judapies/Cabina-Flujo-Vertical/2020/CFLV 90 Avantika Vidrio Electrico #004588284 OP202004/Interfaz Nextion 3.5 Extractora/Imagenes/CabinaB2.png

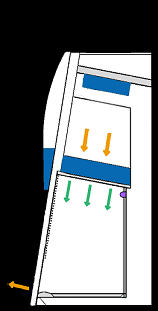
2020/CFLV 90 Avantika Vidrio Electrico #004588284 OP202004/Interfaz Nextion 3.5 Extractora/Imagenes/CabinaB2.png
