judapies/Cabina-Flujo-Vertical/2020/CFLV 90 Avantika Vidrio Electrico #004588284 OP202004/Interfaz Nextion/Imagenes/SOFTWARE_AUTOCLAVE _HORIZONTAL_68L_02-40.png

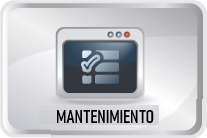
2020/CFLV 90 Avantika Vidrio Electrico #004588284 OP202004/Interfaz Nextion/Imagenes/SOFTWARE_AUTOCLAVE _HORIZONTAL_68L_02-40.png
