judapies/Cabina-Flujo-Vertical/Materiales/Listado de Componentes Cabina de Flujo Laminar  Vertical.xlsx

Sheet: Parte Electronica 110V
 | Cabina Flujo Vertical 110V
 | Descripción | Referencia | Cantidad | Precio | Precio Total | Sitio de Compra | Dirección
 | OptoTriac | MOC3031 | 6 | $2088 | $12528 | Sigma Electronica Ltda | Av. Cra 24 No 61D-65
 | Triac | BT137 | 2 | $1000 | $2000 | Electronica Digitel Ltda | Cra 9 # 19-30 LOC:216/217
 |  | BTA-16 | 4 | $2030 | $8120 | Sigma Electronica Ltda | Av. Cra 24 No 61D-65
 | Borneras | 2 Pines Verdes | 7 | $350 | $2450 | Electronica Digitel Ltda | Cra 9 # 19-30 LOC:216/217
 |  | 3 Pines Verde | 1 | $400 | $400 | Electronica Digitel Ltda | Cra 9 # 19-30 LOC:216/218
 | Conectores GP (con uñas) | 5 Pines | 1 | $400 | $400 | Electronica Digitel Ltda | Cra 9 # 19-30 LOC:216/219
 |  | 16 Pines | 2 | $800 | $1600 | Electronica Digitel Ltda | Cra 9 # 19-30 LOC:216/220
 | Fusible Corto | 500 mA maximo | 1 | $100 | $100 | Electronica Digitel Ltda | Cra 9 # 19-30 LOC:216/221
 | Portafusible Aereo | Para fusible corto | 1 | $600 | $600 | Electronica Digitel Ltda | Cra 9 # 19-30 LOC:216/222
 | Disipador | Mediano para 7805 | 1 | $2000 | $2000 | Electronica Digitel Ltda | Cra 9 # 19-30 LOC:216/223
 | Puente Rectificador | Redondo 1A | 1 | $400 | $400 | Electronica Digitel Ltda | Cra 9 # 19-30 LOC:216/224
 | Regulador de Voltaje | LM7805 | 1 | $550 | $550 | Electronica Digitel Ltda | Cra 9 # 19-30 LOC:216/225
 | Reostato | 10K | 1 | $300 | $300 | Electronica Digitel Ltda | Cra 9 # 19-30 LOC:216/226
 | Cristal de Cuarzo | 4MHz | 1 | $450 | $450 | Electronica Digitel Ltda | Cra 9 # 19-30 LOC:216/227
 | Resistencias 1/4W | 10K | 6 | $10 | $60 | Electronica Digitel Ltda | Cra 9 # 19-30 LOC:216/228
 |  | 1K | 6 | $10 | $60 | Electronica Digitel Ltda | Cra 9 # 19-30 LOC:216/229
 |  | 330R | 6 | $10 | $60 | Electronica Digitel Ltda | Cra 9 # 19-30 LOC:216/230
 | Condensador | 470uF/25V | 1 | $250 | $250 | Electronica Digitel Ltda | Cra 9 # 19-30 LOC:216/231
 |  | 10uF/16V | 3 | $150 | $450 | Electronica Digitel Ltda | Cra 9 # 19-30 LOC:216/232
 |  | 100nF (104) | 2 | $100 | $200 | Electronica Digitel Ltda | Cra 9 # 19-30 LOC:216/233
 |  | 22pF | 2 | $100 | $200 | Electronica Digitel Ltda | Cra 9 # 19-30 LOC:216/234
 | Display | 4X20 | 1 | $25000 | $25000 | Electronica Digitel Ltda | Cra 9 # 19-30 LOC:216/235
 | Transformador | 110V a 0-6-9V 450mA | 1 | $6500 | $6500 | Electronica Digitel Ltda | Cra 9 # 19-30 LOC:216/236
 | Varistor | 20D241K | 2 | $2000 | $4000 | Electronica Digitel Ltda | Cra 9 # 19-30 LOC:216/237
 | Microcontrolador | PIC 18F4550 | 1 | $15000 | $15000 | Electronica Digitel Ltda | Cra 9 # 19-30 LOC:216/238
 | Regleta Profesional | 40 pines | 3 | $1200 | $3600 | Electronica Digitel Ltda | Cra 9 # 19-30 LOC:216/217
 | Poste plastico | Para sujecion de tarjeta | 4 | $150 | $600 | Electronica Digitel Ltda | Cra 9 # 19-30 LOC:216/217
 | Tarjetas Electronicas | Control | 1 | $17000 | $17000 | Yahiko Electronica Ltda | Calle 20 # 8-89
 | Botones | Tipo huevo blanco | 4 | $1800 | $7200 | ATM Store SAS | Cra 9 # 19-30 LOC: 117
 |  |  |  |  | $112078 | TOTAL
Ingenieros | Faiver H. Trujillo G | Juan David Piñeros E | 2014- Abr-15

Sheet: Parte Electrica 110V
Cabina Flujo Vertical 110V
Descripción | Referencia | Cantidad | Precio Unitario | Precio Total
Breaker CHINT 1 polo | 2A | 1 | $10000 | $10000
 | 10A | 1 | $10000 | $10000
Interruptor de balancin redondo | 20mm | 1 | $3000 | $3000
Toma doble blanca | Leviton | 1 | $2800 | $2800
Tapa de seguridad para toma doble | Plastica gris | 1 | $8000 | $8000
Regleta de polietileno | 30A | 1 | $4500 | $4500
Prensacable | PG11 | 4 | $1000 | $4000
Cable Encauchetado Conalcables | 3X12 | 4 | $4500 | $18000
Clavija | 110V 15A Leviton | 1 | $6500 | $6500
 |  |  |  | $66800

Sheet: 220V
 | Cabina Flujo Vertical 220V
 | Descripción | Referencia | Cantidad
 | OptoTriac | MOC3021 | 6
 | Triac | BT137 | 2
 |  | BTA-16 | 4
 | Borneras | 2 Pines Verdes | 7
 |  | 3 Pines Verde | 1
 | Conectores GP (con uñas) | 5 Pines | 1
 |  | 16 Pines | 2
 | Puente Rectificador | Redondo 1A | 1
 | Regulador de Voltaje | LM7805 | 1
 | Reostato | 10K | 1
 | Cristal de Cuarzo | 4MHz | 1
 | Resistencias 1/4W | 10K | 6
 |  | 1K | 6
 |  | 330R | 6
 | Condensador | 470uF/25V | 1
 |  | 10uF/16V | 3
 |  | 100nF (104) | 2
 |  | 22pF | 2
 | Display | 4X20 | 1
 | Microcontrolador | PIC 18F4550 | 1
 | Terminales | Según muestra | 8
 | Breaker CHINT 2 polos | 2A | 1
 | Breaker CHINT 1 polo | 10A | 1
 | Interruptor de balancin redondo | 20mm | 1
 | Toma doble blanca | Leviton | 1
 | Tapa de seguridad para toma doble | Plastica gris | 1
 | Regleta de polietileno | 15A | 1
 | Prensacable | PG11 | 4
 | Cable Encauchetado Conalcables | 4X12 | 3m
Ingenieros | Faiver H. Trujillo G | Juan David Piñeros E | 2014- Abr-15
