judapies/Cabina-Flujo-Vertical/2016/CFLV 120 UPTC/Schematic/Cabina_PCR.DXF

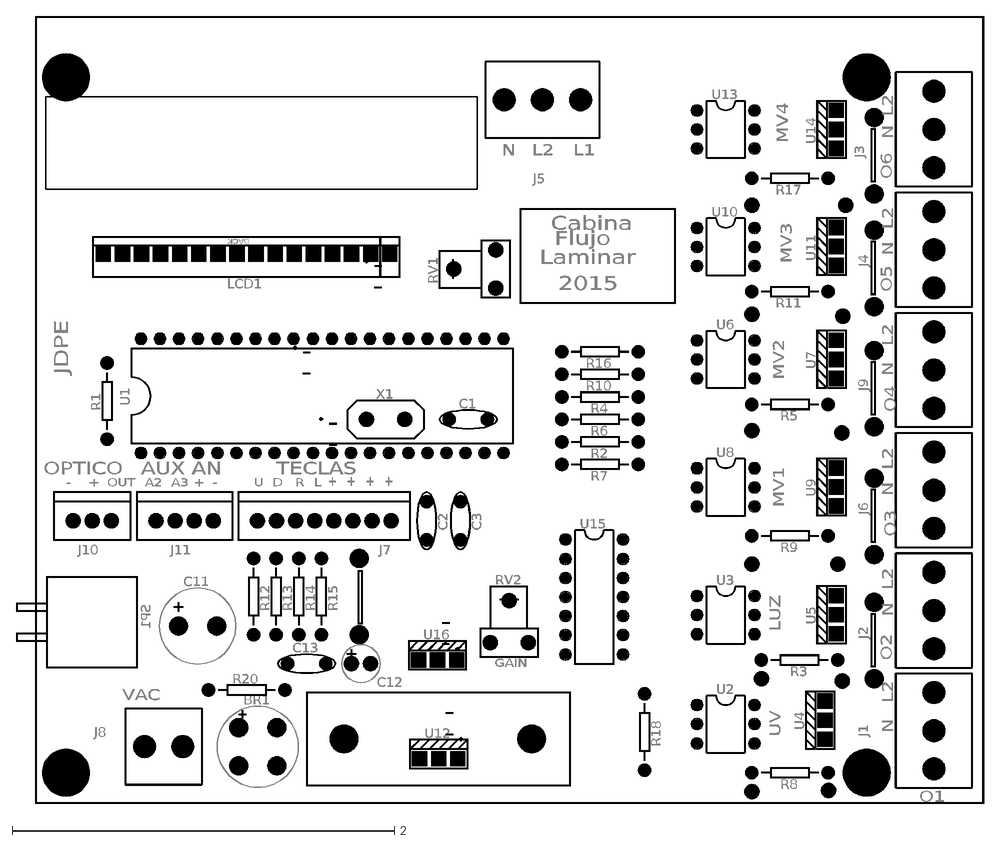
[picture p21: CAD file, 2021-07-15]
2016/CFLV 120 UPTC/Schematic/Cabina_PCR.DXF
BR1
U1
SP1
U15
U16
U12
BACK
LCD1
R1
R2
R7
R4
R6
R10
R16
U2
U3
U6
U8
U13
U10
U4
U5
U7
U9
U11
U14
C2
C3
X1
J7
R12
R13
R14
R15
R3
R5
R8
R9
R11
R17
R20
RV1
J1
J2
J3
J4
J5
J6
J8
J9
J10
J11
RV2
R18
C11
C12
C13
C1
TECLAS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
