judapies/Cabina-Flujo-Vertical/2016/CFLV90 Cabina Especial AVANTIKA #004587575/Schematic/Schematic Puente H MosFet/Puente_H_MosFet.DXF

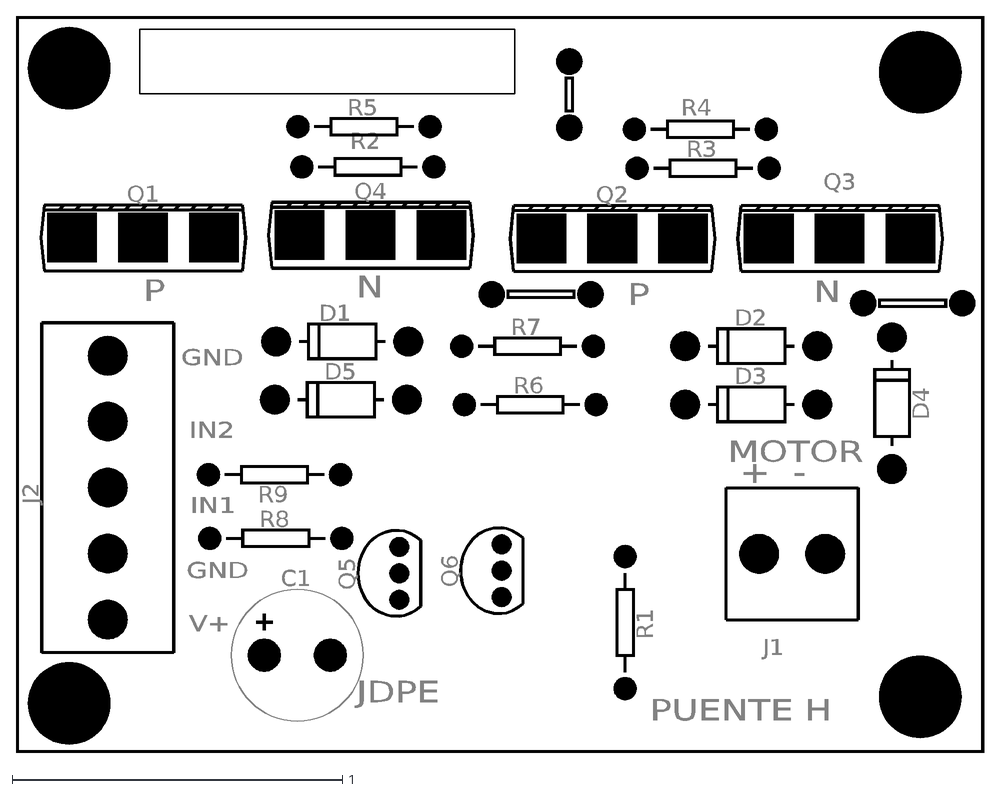
[picture p23: CAD file, 2021-07-15]
2016/CFLV90 Cabina Especial AVANTIKA #004587575/Schematic/Schematic Puente H MosFet/Puente_H_MosFet.DXF
Q1
Q3
Q4
Q2
D1
D5
J2
D2
D3
R7
Q5
Q6
R8
R9
J1
R1
R2
R5
R3
R4
R6
D4
C1
MOTOR
+ -
P
N
JDPE
PUENTE H
GND
V+
IN1
IN2
