judapies/Cabina-Flujo-Vertical/2018/Cabina 170 Avantika # 004587746/Schematic/BioseguridadB2Prueba.DXF

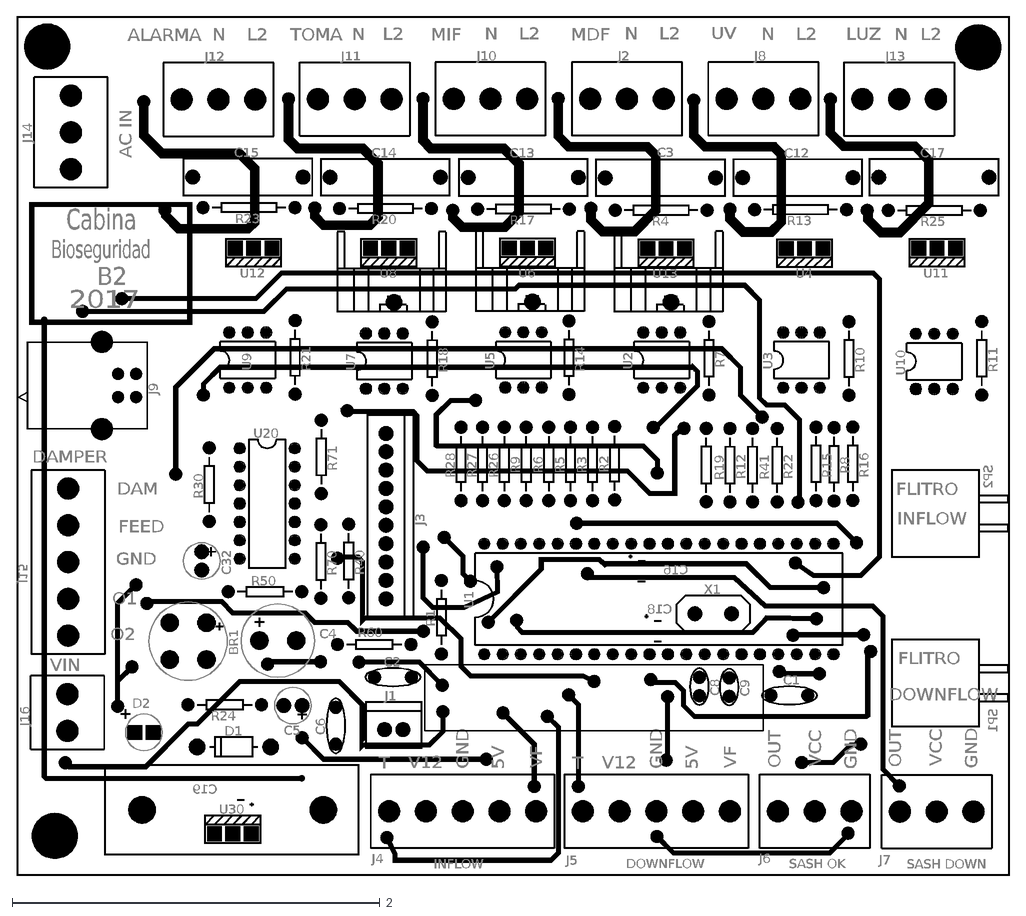
[picture p25: CAD file, 2021-07-15]
2018/Cabina 170 Avantika # 004587746/Schematic/BioseguridadB2Prueba.DXF
BR1
C4
R60
J16
U30
D1
C5
C6
R24
D2
VIN
J4
INFLOW
J5
DOWNFLOW
C19
J6
SASH DOWN
J7
SASH OK
SP1
SP2
J13
LUZ
N
L2
J8
UV
J2
MDF
J10
MIF
J11
TOMA
J12
ALARMA
J14
AC IN
C17
R25
U11
U10
R11
C12
R13
U4
U3
R10
C13
R17
U6
U5
R14
C3
R4
U13
U2
R7
C14
R20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
