judapies/Cabina-Flujo-Vertical/2019/CFLV 60 Biotech #004588076 OP2019207/Schematic/User Library-LCD 4X20.IGS

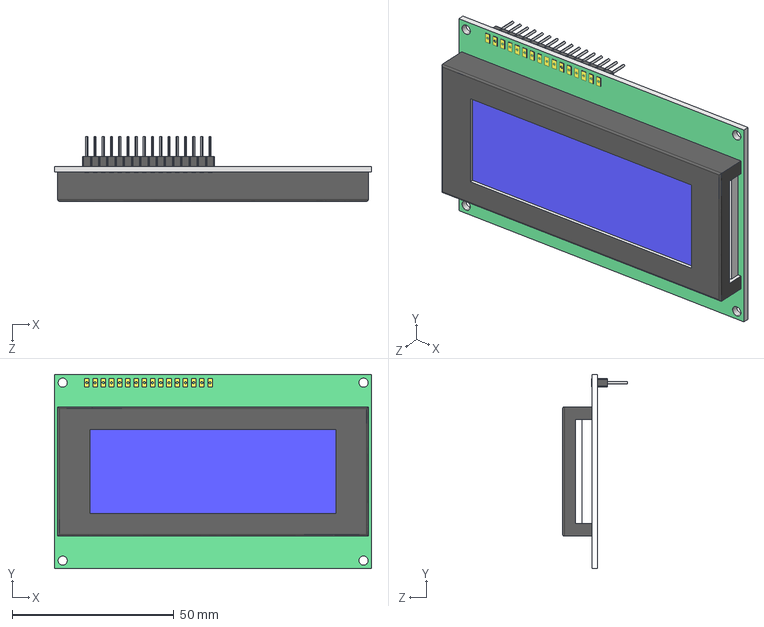
[picture p27: CAD file, 2021-07-15]
2019/CFLV 60 Biotech #004588076 OP2019207/Schematic/User Library-LCD 4X20.IGS
98.0 x 60.0 x 20.0 mm
