judapies/Cabina-Flujo-Vertical/2020/CFLV 120 Avantika #004588233 OP202017/Schematic/CabinaCFLH-V-D4X20.DXF

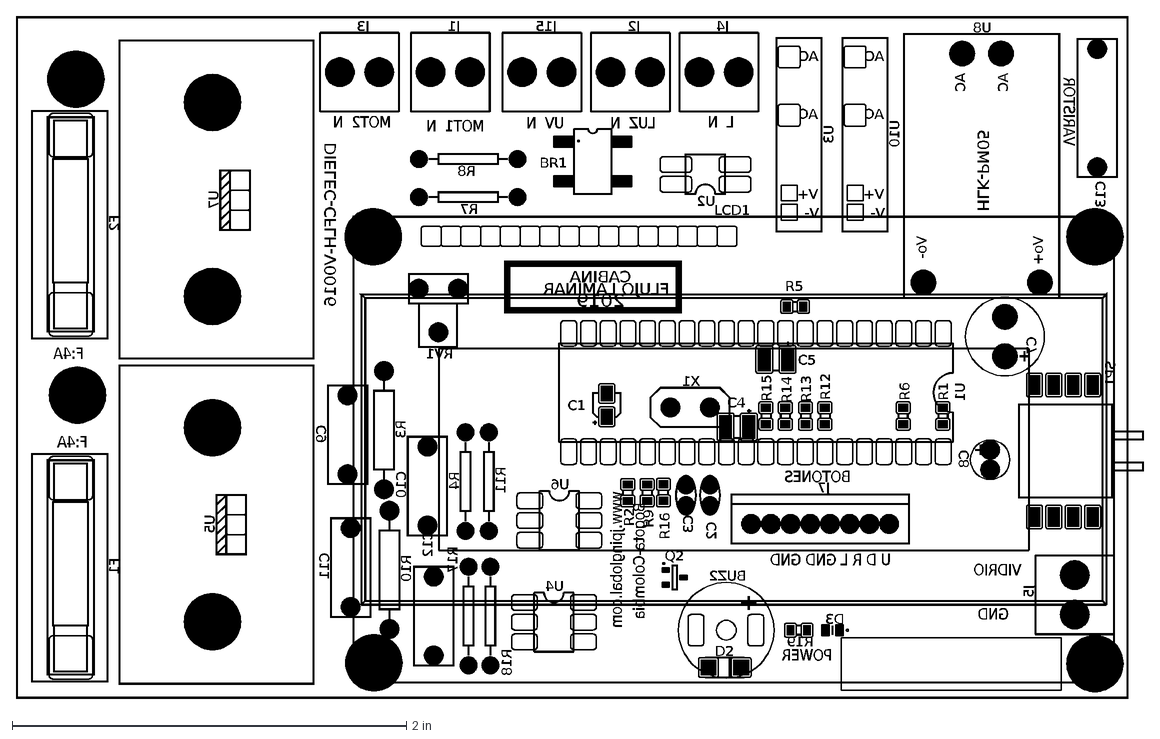
[picture p28: CAD file, 2021-07-15]
2020/CFLV 120 Avantika #004588233 OP202017/Schematic/CabinaCFLH-V-D4X20.DXF
CABINA
FLUJO LAMINAR
2019
Bogota-Colombia
www.jpinglobal.com
HLK-PM05
LCD1
U1
R1
R12
R13
R14
R15
SP1
R6
D3
R19
C2
C3
X1
J5
BR1
J4
R7
R8
U2
R5
R9
U4
R17
R18
U5
C12
R10
C11
F1
R2
U6
R4
R11
C10
R3
C9
U7
F2
J1
J3
J7
R16
Q2
+
BUZ2
D2
RV1
AC
V+
V-
U3
U10
Vo+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
