judapies/Cabina-Flujo-Vertical/2020/CFLV 90 Bioweb Vidrio Electrico #004588176 OP2020128/Plano Electrico/User Library-L298N-3.dxf

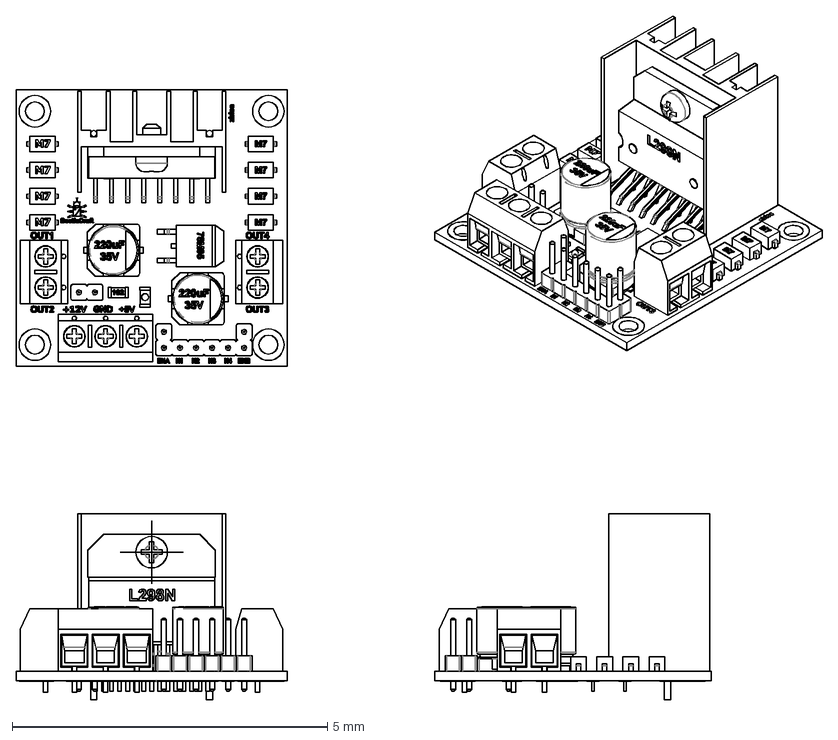
[picture p29: CAD file, 2021-07-15]
2020/CFLV 90 Bioweb Vidrio Electrico #004588176 OP2020128/Plano Electrico/User Library-L298N-3.dxf
12.8 x 10.8 mm
