judapies/Cabina-Flujo-Vertical/2020/CFLV96 Servioptica #004588453 OP2020379/Schematic/CabinaCFLHV-D4X20_SensorFlujo.DXF

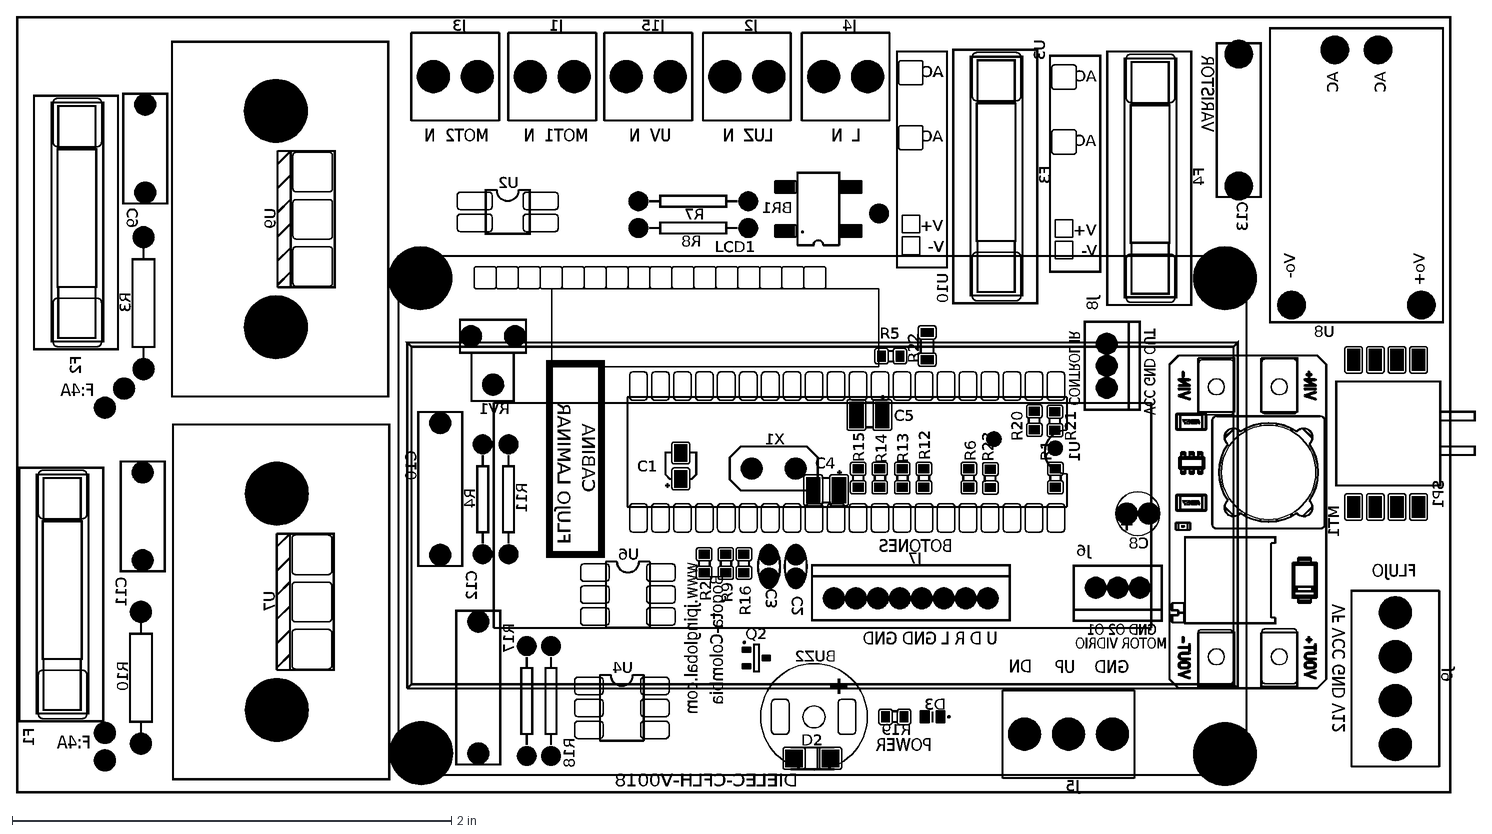
[picture p30: CAD file, 2021-07-15]
2020/CFLV96 Servioptica #004588453 OP2020379/Schematic/CabinaCFLHV-D4X20_SensorFlujo.DXF
CABINA
FLUJO LAMINAR
Bogota-Colombia
www.jpinglobal.com
LCD1
U1
R1
R12
R13
R14
R15
SP1
R6
D3
R19
C2
C3
X1
BR1
J4
R7
R8
U2
R5
R9
U4
R17
R18
C12
R10
C11
F1
R2
U6
R4
R11
C10
R3
C9
F2
J1
J3
J7
R16
Q2
+
BUZ2
D2
RV1
AC
V+
V-
U3
U10
Vo+
Vo-
U8
J2
J15
C13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
