judapies/Cabina-Flujo-Vertical/2018/Cabina 170 Avantika # 004587746/Schematic/BioseguridadB2.DXF

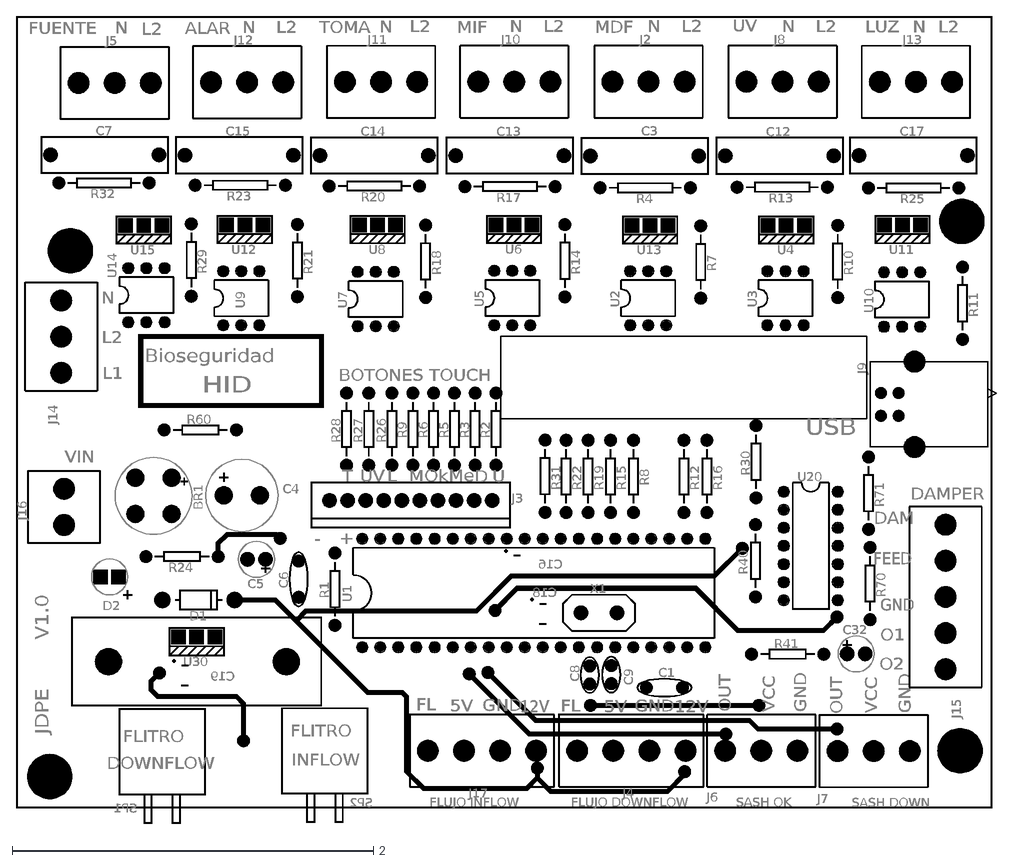
[picture p31: CAD file, 2021-07-15]
2018/Cabina 170 Avantika # 004587746/Schematic/BioseguridadB2.DXF
BR1
C4
J16
U30
D1
C5
C6
R24
D2
VIN
C19
J6
SASH DOWN
J7
SASH OK
SP1
SP2
J13
LUZ
N
L2
J8
UV
J2
MDF
J10
MIF
J11
TOMA
J12
ALAR
J14
C17
R25
U11
U10
R11
C12
R13
U4
U3
R10
C13
R17
U6
U5
R14
C3
R4
U13
U2
R7
C14
R20
U8
U7
R18
C15
R23
U12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
