judapies/Cabina-Flujo-Vertical/(list of files, cad)

Other CAD files:
2014/Plano Electrico/Plano_Electrico_Cabina_Flujo_Vertical/Distribución de Conexiones.dwg
2015/Cabina Flujo Vertical 90- Bogotá/Plano Electrico/Mini-Cabina 110VAC/Distribucion de conexiones.dwg
2015/Cabina Flujo Vertical 90- Bogotá/Plano Electrico/Plano_Electrico_Cabina_Flujo_Vertical/Conexiones de Panel de Control.dwg
2016/CFLV 120 UPTC/Plano Electrico/Plano Electrico Cabina Flujo Laminar Vertical/ConexionesElectricasYElectronicas.dwg
2016/CFLV 90 Microlab/Plano Electrico/Plano Electrico Cabina Flujo Laminar Vertical/ConexionesElectricasYElectronicas.dwg
2016/CFLV90 Cabina Especial AVANTIKA #004587575/Plano Electrico CFLV Especial/Conexiones Caja Electrica.dwg
2017/CFLV 120 Avantika #004587670/Plano Electrico/Plano Electrico CFLV2017/ConexionesElectricasYElectronicas.dwg
2017/CFLV 120 Medellin #00457803/Plano Electrico/Plano Electrico Cabina Flujo Laminar Vertical/ConexionesElectricasYElectronicas.dwg
2017/CFLV 90 Ilube #004587677/Plano Electrico/Plano Electrico CFLV2017/ConexionesElectricasYElectronicas.dwg
2018/Cabina 170 Avantika # 004587746/Plano Electrico CFLV Touch/Conexiones Caja Electrica.dwg
2018/CFLV 120 Belleza Express #004587840/Plano Electrico/Plano Electrico Cabina Flujo Vertical/ConexionesElectricasYElectronicas.dwg
2018/CFLV 120 Eliseo #004587783/Plano Electrico/Plano Electrico Cabina Flujo Vertical/ConexionesElectricasYElectronicas.dwg
2018/CFLV 120 La Arboleda #004587847/Plano Electrico/Plano Electrico Cabina Flujo Vertical/ConexionesElectricasYElectronicas.dwg
2018/CFLV 120 Philters #004587834/Plano Electrico/Plano Electrico Cabina Flujo Vertical/ConexionesElectricasYElectronicas.dwg
2018/CFLV 120 Procaps #004587833/Plano Electrico/Plano Electrico Cabina Flujo Vertical/ConexionesElectricasYElectronicas.dwg
2018/CFLV 160 V2.0 InterSum #004587865/Plano Electrico/Plano Electrico Cabina Flujo Vertical/ConexionesElectricasYElectronicas.dwg
2018/CFLV 160 V2.0 InterSum #004587866/Plano Electrico/Plano Electrico Cabina Flujo Vertical/ConexionesElectricasYElectronicas.dwg
2018/CFLV 90 Biocrop #004587787/Plano Electrico/Plano Electrico Cabina Flujo Vertical/ConexionesElectricasYElectronicas.dwg
2018/CFLV 90 DYM #004587838/Plano Electrico/Plano Electrico Cabina Flujo Vertical/ConexionesElectricasYElectronicas.dwg
2018/CFLV 90 V2.0 Abaco #004587877/Plano Electrico/Plano Electrico Cabina Flujo Vertical/ConexionesElectricasYElectronicas.dwg
2018/CFLV 90 V2.0 Abaco #004587901/Plano Electrico/Plano Electrico Cabina Flujo Vertical/ConexionesElectricasYElectronicas.dwg
2018/CFLV 90 V2.0 Avantika #004587855/Plano Electrico/Plano Electrico Cabina Flujo Vertical/ConexionesElectricasYElectronicas.dwg
2018/CFLV 90 V2.0 Avantika #004587856/Plano Electrico/Plano Electrico Cabina Flujo Vertical/ConexionesElectricasYElectronicas.dwg
2018/CFLV 90 V2.0 Expalsa Ecuador #004587862/Plano Electrico/Plano Electrico Cabina Flujo Vertical/ConexionesElectricasYElectronicas.dwg
2018/CFLV 90 V2.0 Philters #004587909/Plano Electrico/Plano Electrico Cabina Flujo Vertical/ConexionesElectricasYElectronicas.dwg
2019/CFLV 120 V2.0 Artilab #004587961-OP201979/Plano Electrico/Plano Electrico Cabina Flujo Vertical/ConexionesElectricasYElectronicas.dwg
2019/CFLV 120 V2.0 MicroLab SAS #004587974-OP201980/Plano Electrico/Plano Electrico Cabina Flujo Vertical/ConexionesElectricasYElectronicas.dwg
2019/CFLV 60 Biotech #004588076 OP2019207/Plano Electrico/Plano Electrico Cabina CFLH/ConexionesElectricasYElectronicas.dwg
2019/CFLV 60 Organico Boyaca #004587945/Plano Electrico/Plano Electrico Cabina Flujo Vertical/ConexionesElectricasYElectronicas.dwg
2019/CFLV 60 Sandra Tovar #004587944/Plano Electrico/Plano Electrico Cabina Flujo Vertical/ConexionesElectricasYElectronicas.dwg
2019/CFLV 60 V2.0 Wilson Mocoso #004587992 OP2019124/Plano Electrico/Plano Electrico Cabina Flujo Vertical/ConexionesElectricasYElectronicas.dwg
2019/CFLV 90 Biomedical #004588027 OP2019148/Plano Electrico/Plano Electrico Cabina CFLH/ConexionesElectricasYElectronicas.dwg
2019/CFLV 90 Bioweb #004588030 OP2019192/Plano Electrico/Plano Electrico Cabina CFLH/ConexionesElectricasYElectronicas.dwg
2019/CFLV 90 CEPROFIS #004588018 OP2019179/Plano Electrico/Plano Electrico Cabina CFLH/ConexionesElectricasYElectronicas.dwg
2019/CFLV 90 V2.0 Artilab #004587953/Plano Electrico/Plano Electrico Cabina Flujo Vertical/ConexionesElectricasYElectronicas.dwg
2019/CFLV 90 V2.0 Artilab #004587959/Plano Electrico/Plano Electrico Cabina Flujo Vertical/ConexionesElectricasYElectronicas.dwg
2019/CFLV 90 V2.0 Artilab #004587993 OP2019122/Plano Electrico/Plano Electrico Cabina Flujo Vertical/ConexionesElectricasYElectronicas.dwg
2019/CFLV 90 V2.0 MacPollo #004587916/Plano Electrico/Plano Electrico Cabina Flujo Vertical/ConexionesElectricasYElectronicas.dwg
2019/CFLV 90 V2.0 Suministros 724 #004587958/Plano Electrico/Plano Electrico Cabina Flujo Vertical/ConexionesElectricasYElectronicas.dwg
2019/CFLV 90 V2.0 TIM #004587914/Plano Electrico/Plano Electrico Cabina Flujo Vertical/ConexionesElectricasYElectronicas.dwg
2020/CFLV 120 Artilab #004588349 OP2020281/Plano Electrico Cabina CFLH-V/ConexionesElectricasYElectronicas.dwg
2020/CFLV 120 Artilab #004588441 OP2020377/Plano Electrico Cabina CFLH-V/ConexionesElectricasYElectronicas.dwg
2020/CFLV 120 Avantika #004588233 OP202017/Plano Electrico/Plano Electrico Cabina CFLH/ConexionesElectricasYElectronicas.dwg
2020/CFLV 120 CIAD #004588163 OP2020136/Plano Electrico/Plano Electrico Cabina CFLH/ConexionesElectricasYElectronicas.dwg
2020/CFLV 60 Aqua #004588423 OP2020358/Plano Electrico Cabina CFLH-V/ConexionesElectricasYElectronicas.dwg
2020/CFLV 60 Artilab #004588082 OP2019202/Plano Electrico/Plano Electrico Cabina CFLH/ConexionesElectricasYElectronicas.dwg
2020/CFLV 60 Bioweb #004588117 OP202056/Plano Electrico/Plano Electrico Cabina CFLH/ConexionesElectricasYElectronicas.dwg
2020/CFLV 60 Miomed #004588238 OP2020164/Plano Electrico/Plano Electrico Cabina CFLH/ConexionesElectricasYElectronicas.dwg
2020/CFLV 90 Abaco #004588299 OP2020225/Plano Electrico Cabina CFLH-V/ConexionesElectricasYElectronicas.dwg
2020/CFLV 90 Avantika Vidrio Electrico #004588284 OP202004/Plano Electrico CEGHSD HMI/Conexiones_Panel_Control.dwg
2020/CFLV 90 Bioweb Vidrio Electrico #004588176 OP2020128/Plano Electrico/Plano Electrico Cabina CFLH-V/ConexionesElectricasYElectronicas.dwg
2020/CFLV 90 CASTEM #004588388 OP2020331/Plano Electrico Cabina CFLH-V/ConexionesElectricasYElectronicas.dwg
2020/CFLV 90 NOVA #004588389 OP2020321/Plano Electrico Cabina CFLH-V/ConexionesElectricasYElectronicas.dwg
2020/CFLV 90 Suministros 724 #004588439 OP2020370/Plano Electrico Cabina CFLH-V/ConexionesElectricasYElectronicas.dwg
2020/CFLV96 Servioptica #004588453 OP2020379/Plano Electrico/Plano Electrico Cabina CFLH/ConexionesElectricasYElectronicas.dwg
2021/CFLV 120 Armando Pozo Ortega #004588637 OP20211154/Plano Electrico Cabina CFLH-V/ConexionesElectricasYElectronicas.dwg
2021/CFLV 120 Artilab #004588504 OP202105/Plano Electrico Cabina CFLH-V/ConexionesElectricasYElectronicas.dwg
2021/CFLV 120 Avantika #004588508 OP202113/Plano Electrico Cabina CFLH-V/ConexionesElectricasYElectronicas.dwg
2021/CFLV 120 Embotelladora del Tolima #004588617 OP2021100/Plano Electrico Cabina CFLH-V/ConexionesElectricasYElectronicas.dwg
2021/CFLV 120 Gain Capital #004588614 OP2021107/Plano Electrico Cabina CFLH-V/ConexionesElectricasYElectronicas.dwg
2021/CFLV 120 Hansen #004588465 OP2020397/Plano Electrico Cabina CFLH-V/ConexionesElectricasYElectronicas.dwg
2021/CFLV 60 Distriquimicos Aldir #004588583 OP202180/Plano Electrico Cabina CFLH-V/ConexionesElectricasYElectronicas.dwg
2021/CFLV 60 Laboratorio Clinico Integral #004588467 OP2020409/Plano Electrico Cabina CFLH-V/ConexionesElectricasYElectronicas.dwg
2021/CFLV 60 MDM Cientifica #004588597 OP202198/Plano Electrico Cabina CFLH-V/ConexionesElectricasYElectronicas.dwg
2021/CFLV 60 Sin Cliente #004588623 OP2021XX/Plano Electrico Cabina CFLH-V/ConexionesElectricasYElectronicas.dwg
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
