judapies/Cabina-Flujo-Vertical/2016/CFLV 120 UPTC/Plano Electrico/Plano Electrico Cabina Flujo Laminar Vertical/ConexionesElectricasYElectronicas.pdf

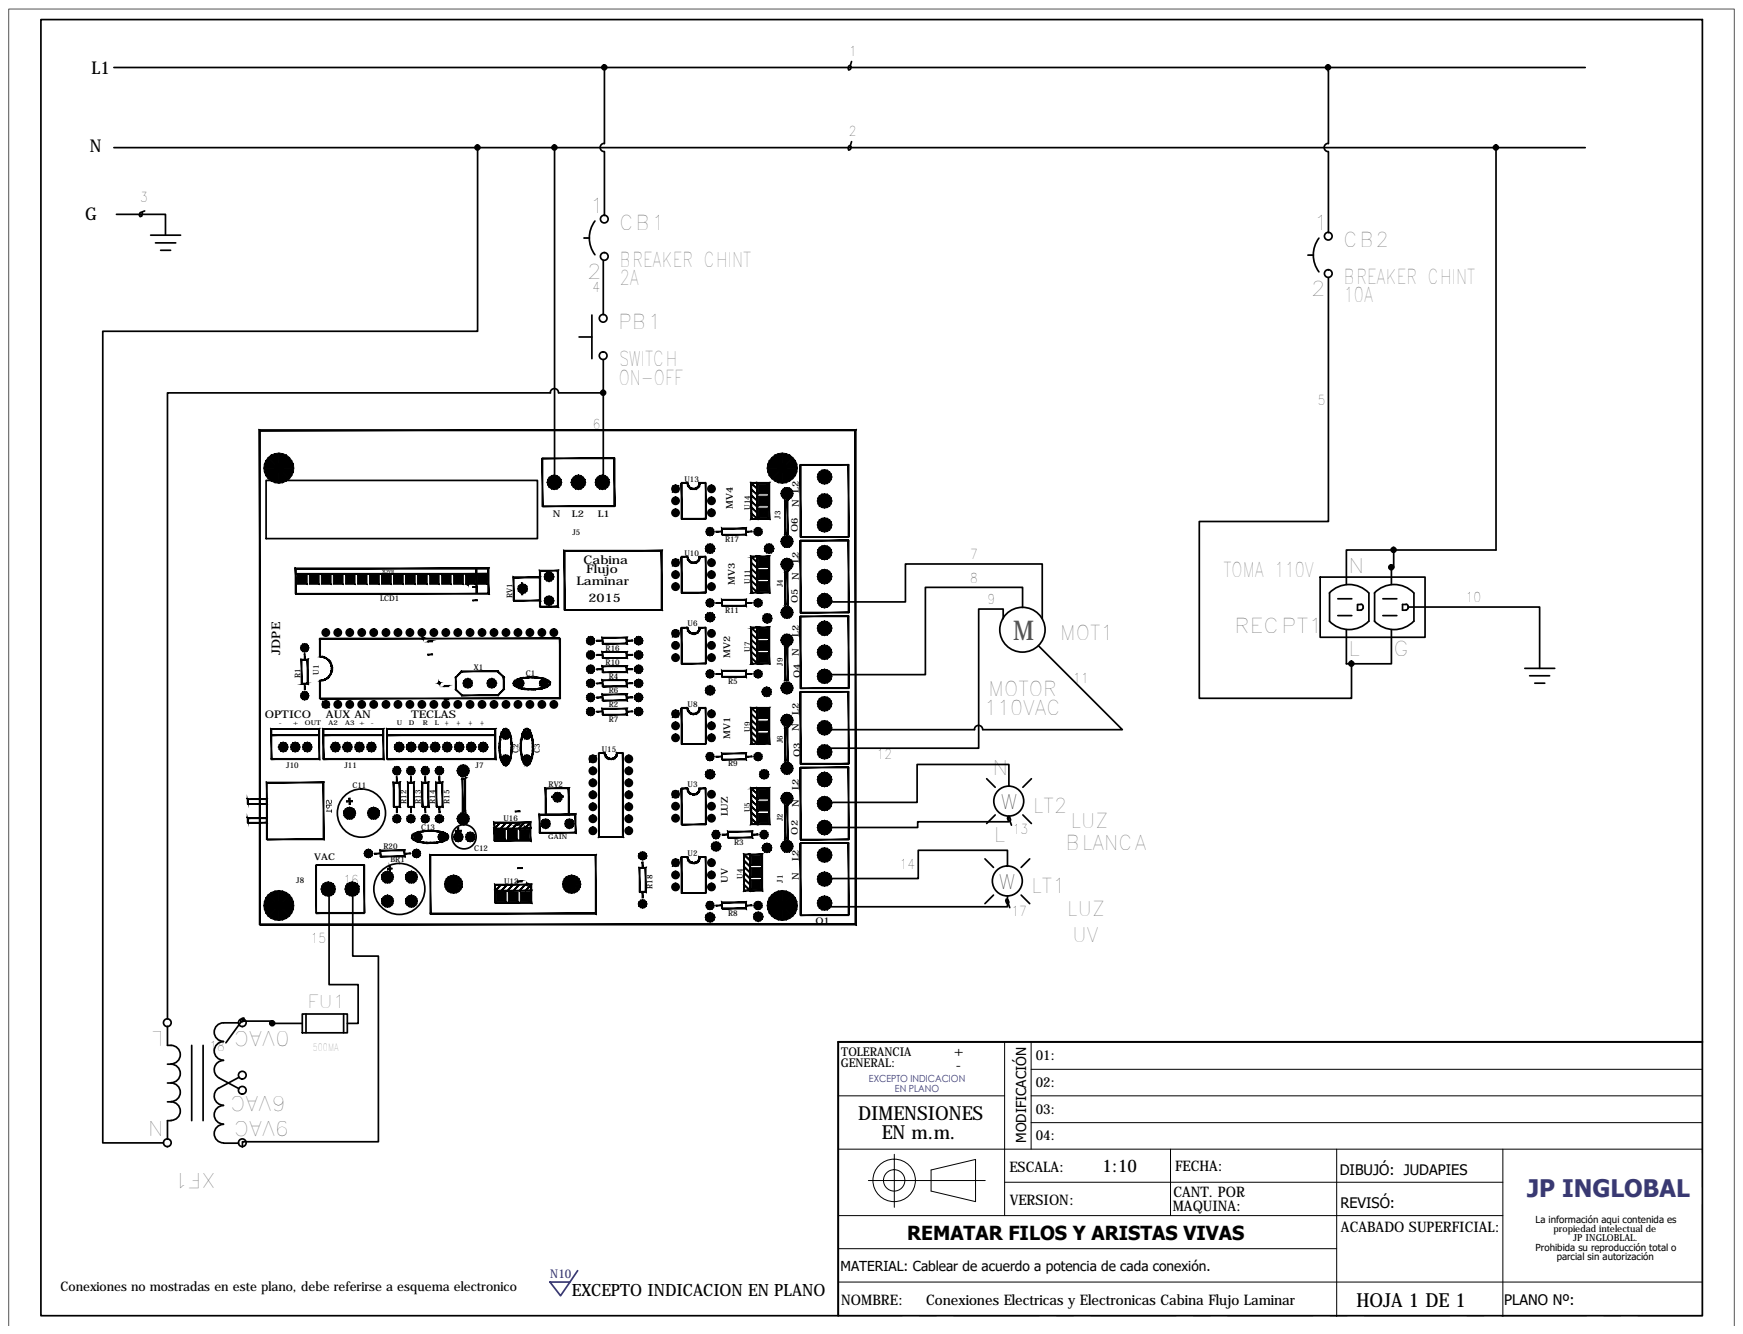
[picture p112: page 1]

02',),&$&,Ï1 NOMBRE: Conexiones Electricas y Electronicas Cabina Flujo Laminar CANT. POR MAQUINA: 01: L1N Conexiones no mostradas en este plano, debe referirse a esquema electronico 12 G 3 BR1

O6 O5 O4 O3 O2 O1 20152ABREAKER CHINT CB1 21 ON-OFF SWITCH PB1 LT1 UV LUZ WLN LT2BLANCA LUZ WMOTOR 110VAC M MOT1 6VAC LN XF1 9VAC 0VAC 500MA FU1 10A BREAKER CHINT CB2 21 L G TOMA 110V N RECPT1 4 5 6 78 9 10 11 12 13 14 15 16 17 18

R18 C11 C12 C13 C1 TECLAS U D R L ++++ AUX AN A2 A3 + - OPTICO - + OUT GAIN VAC N L2 L1 Cabina Flujo Laminar
