judapies/Cabina-Flujo-Vertical/2020/CFLV96 Servioptica #004588453 OP2020379/Plano Electrico/Plano Electrico Cabina CFLH/PlanoPCR.pdf

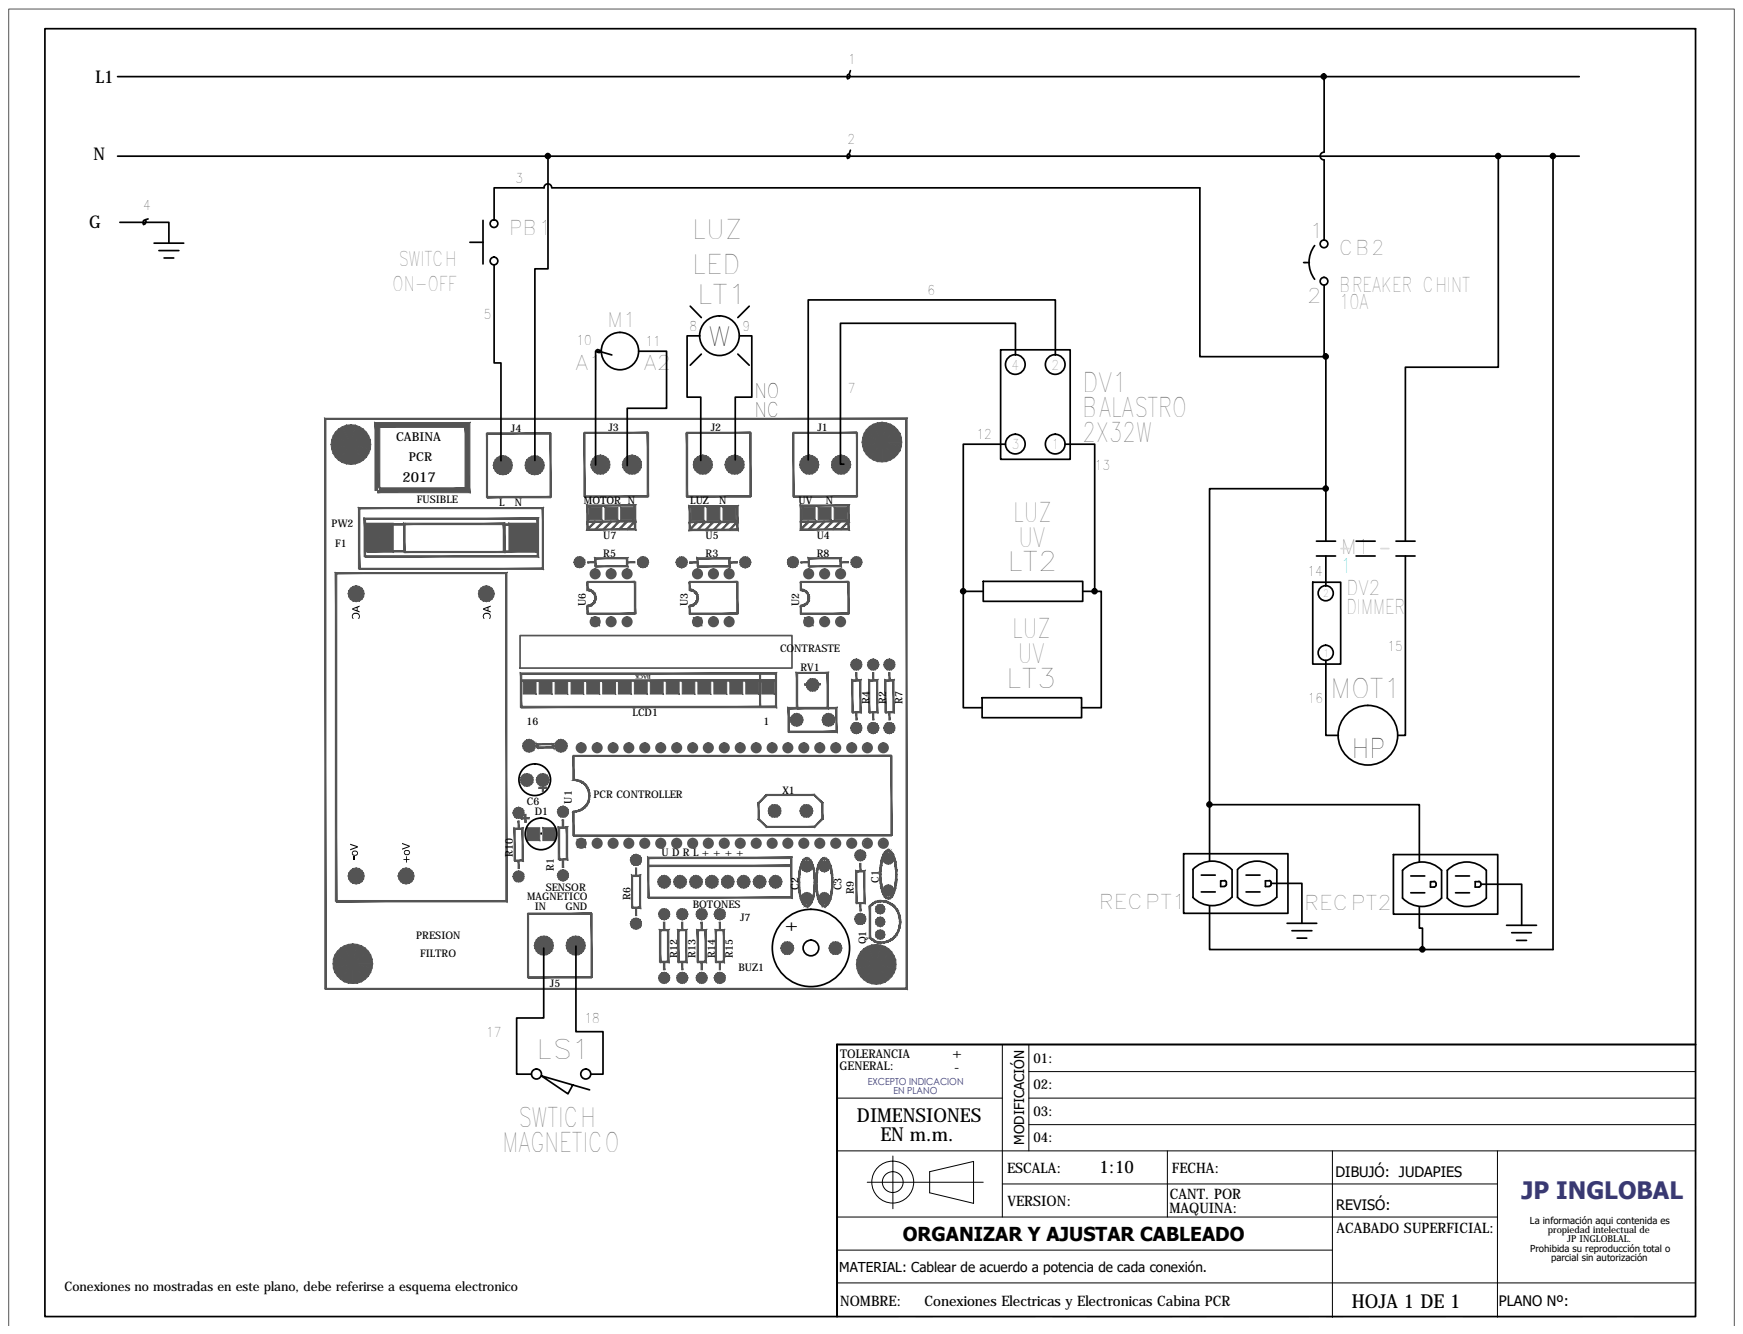
[picture p113: page 1]

02',),&$&,Ï1 NOMBRE: Conexiones Electricas y Electronicas Cabina PCR CANT. POR MAQUINA: 01: L1N Conexiones no mostradas en este plano, debe referirse a esquema electronico 12 G 4 ON-OFF SWITCH PB1 10A BREAKER CHINT CB2 21

R10 3 BALASTRO 2X32W 4 21 DV1 LED LUZ LT1W UV LUZ LT2 5 6 7 8 9 13 HP MOT1 NCNO A1 A2 M1 1M1 3 10 11 12 14 15 MAGNETICO SWTICH LS1 DIMMER 21 DV2 16 17 18 UV LUZ LT3 RECPT1 RECPT2

U2 R5 R8 U7 U5 U4 J3 J2 J1 F1 CABINA PCR 2017 C6 PW2 PCR CONTROLLER BOTONES U D R L + + + + SENSOR MAGNETICO IN GND PRESION FILTRO 16 1 CONTRASTE FUSIBLE L N MOTOR N LUZ N UV N + BUZ1 Q1 R9 D1
