judapies/Cabina-Flujo-Vertical/(list of files, drawings)

Other design files:
2014/Schematic/Cabina_Flujo_Vertical.DSN
2014/Schematic/Cabina_Flujo_Vertical.LYT
2015/Cabina Flujo Vertical 90- Bogotá/Schematic/Cabina_Flujo_Vertical.DSN
2015/Cabina Flujo Vertical 90- Bogotá/Schematic/Cabina_Flujo_Vertical.LYT
2016/CFLV90 Cabina Especial AVANTIKA #004587575/Schematic/CabinaEspecial.DSN
2016/CFLV90 Cabina Especial AVANTIKA #004587575/Schematic/CabinaEspecial.LYT
2016/CFLV90 Cabina Especial AVANTIKA #004587575/Schematic/Schematic Puente H MosFet/Puente_H_MosFet.DSN
2016/CFLV90 Cabina Especial AVANTIKA #004587575/Schematic/Schematic Puente H MosFet/Puente_H_MosFet.LYT
2016/CFLV 90 Microlab/Schematic/Cabina_PCR.DSN
2016/CFLV 90 Microlab/Schematic/Cabina_PCR.LYT
2016/CFLV 120 UPTC/Schematic/Cabina_PCR.DSN
2016/CFLV 120 UPTC/Schematic/Cabina_PCR.LYT
2017/CFLV 90 Ilube #004587677/Schematic/Cabina_PCR.DSN
2017/CFLV 90 Ilube #004587677/Schematic/Cabina_PCR.LYT
2017/CFLV 120 Avantika #004587670/Schematic/Cabina_PCR.DSN
2017/CFLV 120 Avantika #004587670/Schematic/Cabina_PCR.LYT
2017/CFLV 120 Medellin #00457803/Schematic/Cabina_PCR.DSN
2017/CFLV 120 Medellin #00457803/Schematic/Cabina_PCR.LYT
2018/Cabina 170 Avantika # 004587746/Schematic/BioseguridadB2.DSN
2018/Cabina 170 Avantika # 004587746/Schematic/BioseguridadB2.LYT
2018/Cabina 170 Avantika # 004587746/Schematic/BioseguridadB2Prueba.LYT
2018/Cabina 170 Avantika # 004587746/Schematic/touch.LYT
2018/CFLV 90 Biocrop #004587787/Schematic/Cabina_PCR.DSN
2018/CFLV 90 Biocrop #004587787/Schematic/Cabina_PCR.LYT
2018/CFLV 90 DYM #004587838/Schematic/Cabina_PCR.DSN
2018/CFLV 90 DYM #004587838/Schematic/Cabina_PCR.LYT
2018/CFLV 90 V2.0 Abaco #004587877/Schematic con Seleccion de Velocidad/CabinaCFLH-V.pdsprj
2018/CFLV 90 V2.0 Abaco #004587901/Schematic con Seleccion de Velocidad/CabinaCFLH-V.pdsprj
2018/CFLV 90 V2.0 Avantika #004587855/Schematic con Seleccion de Velocidad/CabinaCFLH-V.pdsprj
2018/CFLV 90 V2.0 Avantika #004587856/Schematic con Seleccion de Velocidad/CabinaCFLH-V.pdsprj
2018/CFLV 90 V2.0 Expalsa Ecuador #004587862/Schematic con Seleccion de Velocidad/CabinaCFLH-V.pdsprj
2018/CFLV 90 V2.0 Philters #004587909/Schematic con Seleccion de Velocidad/CabinaCFLH-V.pdsprj
2018/CFLV 120 Belleza Express #004587840/Schematic/Cabina_PCR.DSN
2018/CFLV 120 Belleza Express #004587840/Schematic/Cabina_PCR.LYT
2018/CFLV 120 Eliseo #004587783/Schematic/Cabina_PCR.DSN
2018/CFLV 120 Eliseo #004587783/Schematic/Cabina_PCR.LYT
2018/CFLV 120 La Arboleda #004587847/Schematic/Cabina_PCR.DSN
2018/CFLV 120 La Arboleda #004587847/Schematic/Cabina_PCR.LYT
2018/CFLV 120 Philters #004587834/Schematic/Cabina_PCR.DSN
2018/CFLV 120 Philters #004587834/Schematic/Cabina_PCR.LYT
2018/CFLV 120 Procaps #004587833/Schematic/Cabina_PCR.DSN
2018/CFLV 120 Procaps #004587833/Schematic/Cabina_PCR.LYT
2018/CFLV 160 V2.0 InterSum #004587865/Schematic con Seleccion de Velocidad/CabinaCFLH-V.pdsprj
2018/CFLV 160 V2.0 InterSum #004587866/Schematic con Seleccion de Velocidad/CabinaCFLH-V.pdsprj
2019/CFLV 60 Biotech #004588076 OP2019207/Schematic/AcopleFuente.pdsprj
2019/CFLV 60 Biotech #004588076 OP2019207/Schematic/CabinaCFLH-V-D4X20.pdsprj
2019/CFLV 60 Organico Boyaca #004587945/Schematic con Seleccion de Velocidad/CabinaCFLH-V.pdsprj
2019/CFLV 60 Sandra Tovar #004587944/Schematic con Seleccion de Velocidad/CabinaCFLH-V.pdsprj
2019/CFLV 60 V2.0 Wilson Mocoso #004587992 OP2019124/Schematic con Seleccion de Velocidad/CabinaCFLH-V.pdsprj
2019/CFLV 90 Biomedical #004588027 OP2019148/Schematic/AcopleFuente.pdsprj
2019/CFLV 90 Biomedical #004588027 OP2019148/Schematic/CabinaCFLH-V-D4X20.pdsprj
2019/CFLV 90 Bioweb #004588030 OP2019192/Schematic/AcopleFuente.pdsprj
2019/CFLV 90 Bioweb #004588030 OP2019192/Schematic/CabinaCFLH-V-D4X20.pdsprj
2019/CFLV 90 CEPROFIS #004588018 OP2019179/Schematic/AcopleFuente.pdsprj
2019/CFLV 90 CEPROFIS #004588018 OP2019179/Schematic/CabinaCFLH-V-D4X20.pdsprj
2019/CFLV 90 V2.0 Artilab #004587953/Schematic con Seleccion de Velocidad/CabinaCFLH-V.pdsprj
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
