judapies/Cabina-Flujo-Vertical/2020/CFLV 90 Avantika Vidrio Electrico #004588284 OP202004/Parametros.txt

Aj. P inf: 0.5
Aj. P dnf: 1.0
Cero P Inf:204
Cero p don:204
Aj. Dn:1.0
Aj. In:0.7
Cero Dn:209
Cero In:203
Velocidad:3
Relac:0.58
Velocidad 2: 5
