judapies/Cabina-Flujo-Vertical/2018/Cabina 170 Avantika # 004587746/Software RPi B2/CabinaBioseguridad/src/Interfaz/Menu_FuncionamientoMotor.java

/*
 * To change this license header, choose License Headers in Project Properties.
 * To change this template file, choose Tools | Templates
 * and open the template in the editor.
 */
package Interfaz;

import java.awt.Color;

/**
 *
 * @author JP Electronica
 */
public class Menu_FuncionamientoMotor extends javax.swing.JFrame {

    /**
     * Creates new form Menu_Configuracion
     */
    public Menu_FuncionamientoMotor() {
        initComponents();
        setLocationRelativeTo(null);
        LabelEncendera.setForeground(Color.blue);
    }

    /**
     * This method is called from within the constructor to initialize the form.
     * WARNING: Do NOT modify this code. The content of this method is always
     * regenerated by the Form Editor.
     */
    @SuppressWarnings("unchecked")
    // <editor-fold defaultstate="collapsed" desc="Generated Code">//GEN-BEGIN:initComponents
    private void initComponents() {

        jPanel1 = new javax.swing.JPanel();
        jLabel1 = new javax.swing.JLabel();
        jLabel2 = new javax.swing.JLabel();
        jPanel2 = new javax.swing.JPanel();
        jLabel7 = new javax.swing.JLabel();
        jLabel6 = new javax.swing.JLabel();
        jLabel8 = new javax.swing.JLabel();
        LabelEncendera = new javax.swing.JLabel();
        LabelNada = new javax.swing.JLabel();

        setDefaultCloseOperation(javax.swing.WindowConstants.DISPOSE_ON_CLOSE);
        setAlwaysOnTop(true);
        setMinimumSize(new java.awt.Dimension(594, 472));
        setUndecorated(true);

        jPanel1.setMaximumSize(new java.awt.Dimension(594, 472));
        jPanel1.setMinimumSize(new java.awt.Dimension(594, 472));
        jPanel1.setPreferredSize(new java.awt.Dimension(594, 472));

        jLabel1.setFont(new java.awt.Font("Yu Gothic UI", 3, 48)); // NOI18N
        jLabel1.setText("Funcionamiento");

        jLabel2.setFont(new java.awt.Font("Tahoma", 3, 24)); // NOI18N
        jLabel2.setText("Cuando el vidrio este a 20cm el motor");

        jPanel2.setBorder(javax.swing.BorderFactory.createTitledBorder("Tips"));

        jLabel7.setFont(new java.awt.Font("Tahoma", 3, 14)); // NOI18N
        jLabel7.setText("La tecla Menú para Cancelar.");

        jLabel6.setFont(new java.awt.Font("Tahoma", 3, 14)); // NOI18N
        jLabel6.setText("Utilice las teclas Arriba y Abajo para seleccionar.");

        jLabel8.setFont(new java.awt.Font("Tahoma", 3, 14)); // NOI18N
        jLabel8.setText("La tecla OK para Aceptar.");

        javax.swing.GroupLayout jPanel2Layout = new javax.swing.GroupLayout(jPanel2);
        jPanel2.setLayout(jPanel2Layout);
        jPanel2Layout.setHorizontalGroup(
            jPanel2Layout.createParallelGroup(javax.swing.GroupLayout.Alignment.LEADING)
            .addGroup(jPanel2Layout.createSequentialGroup()
                .addContainerGap()
                .addGroup(jPanel2Layout.createParallelGroup(javax.swing.GroupLayout.Alignment.TRAILING)
                    .addComponent(jLabel7, javax.swing.GroupLayout.PREFERRED_SIZE, 415, javax.swing.GroupLayout.PREFERRED_SIZE)
                    .addComponent(jLabel8, javax.swing.GroupLayout.PREFERRED_SIZE, 415, javax.swing.GroupLayout.PREFERRED_SIZE)
                    .addComponent(jLabel6, javax.swing.GroupLayout.PREFERRED_SIZE, 415, javax.swing.GroupLayout.PREFERRED_SIZE))
                .addContainerGap())
        );
        jPanel2Layout.setVerticalGroup(
            jPanel2Layout.createParallelGroup(javax.swing.GroupLayout.Alignment.LEADING)
            .addGroup(jPanel2Layout.createSequentialGroup()
                .addContainerGap()
                .addComponent(jLabel6)
                .addPreferredGap(javax.swing.LayoutStyle.ComponentPlacement.UNRELATED)
                .addComponent(jLabel8)
                .addPreferredGap(javax.swing.LayoutStyle.ComponentPlacement.UNRELATED)
                .addComponent(jLabel7)
                .addContainerGap())
        );

        LabelEncendera.setFont(new java.awt.Font("Tahoma", 3, 24)); // NOI18N
        LabelEncendera.setText("- Se Encendera");

        LabelNada.setFont(new java.awt.Font("Tahoma", 3, 24)); // NOI18N
        LabelNada.setText("- No cambia de Estado");

        javax.swing.GroupLayout jPanel1Layout = new javax.swing.GroupLayout(jPanel1);
        jPanel1.setLayout(jPanel1Layout);
        jPanel1Layout.setHorizontalGroup(
            jPanel1Layout.createParallelGroup(javax.swing.GroupLayout.Alignment.LEADING)
            .addGroup(javax.swing.GroupLayout.Alignment.TRAILING, jPanel1Layout.createSequentialGroup()
                .addGap(0, 0, Short.MAX_VALUE)
                .addGroup(jPanel1Layout.createParallelGroup(javax.swing.GroupLayout.Alignment.LEADING)
                    .addComponent(LabelEncendera, javax.swing.GroupLayout.PREFERRED_SIZE, 210, javax.swing.GroupLayout.PREFERRED_SIZE)
                    .addComponent(LabelNada, javax.swing.GroupLayout.PREFERRED_SIZE, 319, javax.swing.GroupLayout.PREFERRED_SIZE))
                .addGap(204, 204, 204))
            .addGroup(jPanel1Layout.createSequentialGroup()
                .addGroup(jPanel1Layout.createParallelGroup(javax.swing.GroupLayout.Alignment.LEADING)
                    .addGroup(jPanel1Layout.createSequentialGroup()
                        .addGap(45, 45, 45)
                        .addGroup(jPanel1Layout.createParallelGroup(javax.swing.GroupLayout.Alignment.LEADING)
                            .addComponent(jPanel2, javax.swing.GroupLayout.PREFERRED_SIZE, javax.swing.GroupLayout.DEFAULT_SIZE, javax.swing.GroupLayout.PREFERRED_SIZE)
                            .addComponent(jLabel2, javax.swing.GroupLayout.PREFERRED_SIZE, 516, javax.swing.GroupLayout.PREFERRED_SIZE)))
                    .addGroup(jPanel1Layout.createSequentialGroup()
                        .addGap(64, 64, 64)
                        .addComponent(jLabel1, javax.swing.GroupLayout.PREFERRED_SIZE, 451, javax.swing.GroupLayout.PREFERRED_SIZE)))
                .addContainerGap(33, Short.MAX_VALUE))
        );
        jPanel1Layout.setVerticalGroup(
            jPanel1Layout.createParallelGroup(javax.swing.GroupLayout.Alignment.LEADING)
            .addGroup(jPanel1Layout.createSequentialGroup()
                .addGap(25, 25, 25)
                .addComponent(jLabel1)
                .addGap(54, 54, 54)
                .addComponent(jLabel2)
                .addGap(29, 29, 29)
                .addComponent(LabelEncendera)
                .addPreferredGap(javax.swing.LayoutStyle.ComponentPlacement.UNRELATED)
                .addComponent(LabelNada)
                .addPreferredGap(javax.swing.LayoutStyle.ComponentPlacement.RELATED, 87, Short.MAX_VALUE)
                .addComponent(jPanel2, javax.swing.GroupLayout.PREFERRED_SIZE, javax.swing.GroupLayout.DEFAULT_SIZE, javax.swing.GroupLayout.PREFERRED_SIZE))
        );

        javax.swing.GroupLayout layout = new javax.swing.GroupLayout(getContentPane());
        getContentPane().setLayout(layout);
        layout.setHorizontalGroup(
            layout.createParallelGroup(javax.swing.GroupLayout.Alignment.LEADING)
            .addGroup(layout.createSequentialGroup()
                .addComponent(jPanel1, javax.swing.GroupLayout.PREFERRED_SIZE, javax.swing.GroupLayout.DEFAULT_SIZE, javax.swing.GroupLayout.PREFERRED_SIZE)
                .addGap(0, 0, Short.MAX_VALUE))
        );
        layout.setVerticalGroup(
            layout.createParallelGroup(javax.swing.GroupLayout.Alignment.LEADING)
            .addGroup(layout.createSequentialGroup()
                .addComponent(jPanel1, javax.swing.GroupLayout.PREFERRED_SIZE, javax.swing.GroupLayout.DEFAULT_SIZE, javax.swing.GroupLayout.PREFERRED_SIZE)
                .addGap(0, 0, Short.MAX_VALUE))
        );

        pack();
    }// </editor-fold>//GEN-END:initComponents

    /**
     * @param args the command line arguments
     */
    public static void main(String args[]) {
        /* Set the Nimbus look and feel */
        //<editor-fold defaultstate="collapsed" desc=" Look and feel setting code (optional) ">
        /* If Nimbus (introduced in Java SE 6) is not available, stay with the default look and feel.
         * For details see http://download.oracle.com/javase/tutorial/uiswing/lookandfeel/plaf.html 
         */
        try {
            for (javax.swing.UIManager.LookAndFeelInfo info : javax.swing.UIManager.getInstalledLookAndFeels()) {
                if ("Nimbus".equals(info.getName())) {
                    javax.swing.UIManager.setLookAndFeel(info.getClassName());
                    break;
                }
            }
        } catch (ClassNotFoundException ex) {
            java.util.logging.Logger.getLogger(Menu_FuncionamientoMotor.class.getName()).log(java.util.logging.Level.SEVERE, null, ex);
        } catch (InstantiationException ex) {
            java.util.logging.Logger.getLogger(Menu_FuncionamientoMotor.class.getName()).log(java.util.logging.Level.SEVERE, null, ex);
        } catch (IllegalAccessException ex) {
            java.util.logging.Logger.getLogger(Menu_FuncionamientoMotor.class.getName()).log(java.util.logging.Level.SEVERE, null, ex);
        } catch (javax.swing.UnsupportedLookAndFeelException ex) {
            java.util.logging.Logger.getLogger(Menu_FuncionamientoMotor.class.getName()).log(java.util.logging.Level.SEVERE, null, ex);
        }
        //</editor-fold>
        //</editor-fold>
        //</editor-fold>
        //</editor-fold>
        //</editor-fold>
        //</editor-fold>
        //</editor-fold>
        //</editor-fold>

        /* Create and display the form */
        java.awt.EventQueue.invokeLater(new Runnable() {
            public void run() {
                new Menu_FuncionamientoMotor().setVisible(true);
            }
        });
    }

    // Variables declaration - do not modify//GEN-BEGIN:variables
    public static javax.swing.JLabel LabelEncendera;
    public static javax.swing.JLabel LabelNada;
    private javax.swing.JLabel jLabel1;
    private javax.swing.JLabel jLabel2;
    private javax.swing.JLabel jLabel6;
    private javax.swing.JLabel jLabel7;
    private javax.swing.JLabel jLabel8;
    private javax.swing.JPanel jPanel1;
    private javax.swing.JPanel jPanel2;
    // End of variables declaration//GEN-END:variables
}
