judapies/Cabina-Flujo-Vertical/2018/Cabina 170 Avantika # 004587746/Software RPi/CabinaBioseguridad/src/Interfaz/Menu_Mantenimiento.java

/*
 * To change this license header, choose License Headers in Project Properties.
 * To change this template file, choose Tools | Templates
 * and open the template in the editor.
 */
package Interfaz;

import Comunicacion.Variables;

/**
 *
 * @author JP Electronica
 */
public class Menu_Mantenimiento extends javax.swing.JFrame {

    /**
     * Creates new form Menu_TiempoPurga
     */
    public Menu_Mantenimiento() {
        initComponents();
        setLocationRelativeTo(null);
    }

    /**
     * This method is called from within the constructor to initialize the form.
     * WARNING: Do NOT modify this code. The content of this method is always
     * regenerated by the Form Editor.
     */
    @SuppressWarnings("unchecked")
    // <editor-fold defaultstate="collapsed" desc="Generated Code">//GEN-BEGIN:initComponents
    private void initComponents() {

        jPanel1 = new javax.swing.JPanel();
        jLabel1 = new javax.swing.JLabel();
        jPanel3 = new javax.swing.JPanel();
        jLabel3 = new javax.swing.JLabel();
        jLabel2 = new javax.swing.JLabel();
        LabelCeroInflow = new javax.swing.JLabel();
        jLabel4 = new javax.swing.JLabel();
        jLabel5 = new javax.swing.JLabel();
        LabelADCInflow = new javax.swing.JLabel();
        LabelFlujoInflow = new javax.swing.JLabel();
        LabelAjusteInflow = new javax.swing.JLabel();
        jPanel4 = new javax.swing.JPanel();
        jLabel6 = new javax.swing.JLabel();
        jLabel7 = new javax.swing.JLabel();
        LabelCeroDownflow = new javax.swing.JLabel();
        jLabel8 = new javax.swing.JLabel();
        jLabel9 = new javax.swing.JLabel();
        LabelADCDownflow = new javax.swing.JLabel();
        LabelFlujoDownflow = new javax.swing.JLabel();
        LabelAjusteDownflow = new javax.swing.JLabel();
        jPanel5 = new javax.swing.JPanel();
        jLabel10 = new javax.swing.JLabel();
        jLabel11 = new javax.swing.JLabel();
        LabelZeroFInflow = new javax.swing.JLabel();
        jLabel12 = new javax.swing.JLabel();
        jLabel13 = new javax.swing.JLabel();
        LabelADCFInflow = new javax.swing.JLabel();
        LabelPresionInflow = new javax.swing.JLabel();
        LabelAjusteFInflow = new javax.swing.JLabel();
        jPanel6 = new javax.swing.JPanel();
        jLabel14 = new javax.swing.JLabel();
        jLabel15 = new javax.swing.JLabel();
        LabelZeroFDownflow = new javax.swing.JLabel();
        jLabel16 = new javax.swing.JLabel();
        jLabel17 = new javax.swing.JLabel();
        LabelADCFDownflow = new javax.swing.JLabel();
        LabelPresionDownflow = new javax.swing.JLabel();
        LabelAjusteFDownflow = new javax.swing.JLabel();
        jPanel2 = new javax.swing.JPanel();
        jLabel18 = new javax.swing.JLabel();
        LabelVidrioUP = new javax.swing.JLabel();
        LabelVidrioDN = new javax.swing.JLabel();
        jLabel19 = new javax.swing.JLabel();
        LabelDamper = new javax.swing.JLabel();
        jLabel20 = new javax.swing.JLabel();
        LabelTecla = new javax.swing.JLabel();
        jLabel21 = new javax.swing.JLabel();
        jLabel22 = new javax.swing.JLabel();
        LabelVidrioUUP = new javax.swing.JLabel();

        setDefaultCloseOperation(javax.swing.WindowConstants.DISPOSE_ON_CLOSE);
        setAlwaysOnTop(true);
        setMinimumSize(new java.awt.Dimension(594, 472));
        setUndecorated(true);

        jPanel1.setMaximumSize(new java.awt.Dimension(594, 472));
        jPanel1.setMinimumSize(new java.awt.Dimension(594, 472));
        jPanel1.setPreferredSize(new java.awt.Dimension(594, 472));

        jLabel1.setFont(new java.awt.Font("Yu Gothic UI", 3, 48)); // NOI18N
        jLabel1.setHorizontalAlignment(javax.swing.SwingConstants.CENTER);
        jLabel1.setText("Mantenimiento");

        jPanel3.setBorder(javax.swing.BorderFactory.createTitledBorder("Exhaust"));

        jLabel3.setFont(new java.awt.Font("Tahoma", 0, 24)); // NOI18N
        jLabel3.setText("ADC:");

        jLabel2.setFont(new java.awt.Font("Tahoma", 0, 24)); // NOI18N
        jLabel2.setText("Cero:");

        LabelCeroInflow.setFont(new java.awt.Font("Tahoma", 0, 24)); // NOI18N
        LabelCeroInflow.setText("203");

        jLabel4.setFont(new java.awt.Font("Tahoma", 0, 24)); // NOI18N
        jLabel4.setText("Ajuste *:");

        jLabel5.setFont(new java.awt.Font("Tahoma", 0, 24)); // NOI18N
        jLabel5.setText("Flujo:");

        LabelADCInflow.setFont(new java.awt.Font("Tahoma", 0, 24)); // NOI18N
        LabelADCInflow.setText("203");

        LabelFlujoInflow.setFont(new java.awt.Font("Tahoma", 0, 24)); // NOI18N
        LabelFlujoInflow.setText("0.53");

        LabelAjusteInflow.setFont(new java.awt.Font("Tahoma", 0, 24)); // NOI18N
        LabelAjusteInflow.setText("1.0");

        javax.swing.GroupLayout jPanel3Layout = new javax.swing.GroupLayout(jPanel3);
        jPanel3.setLayout(jPanel3Layout);
        jPanel3Layout.setHorizontalGroup(
            jPanel3Layout.createParallelGroup(javax.swing.GroupLayout.Alignment.LEADING)
            .addGroup(jPanel3Layout.createSequentialGroup()
                .addContainerGap()
                .addGroup(jPanel3Layout.createParallelGroup(javax.swing.GroupLayout.Alignment.LEADING)
                    .addGroup(jPanel3Layout.createSequentialGroup()
                        .addGroup(jPanel3Layout.createParallelGroup(javax.swing.GroupLayout.Alignment.LEADING)
                            .addComponent(jLabel4)
                            .addComponent(jLabel5))
                        .addPreferredGap(javax.swing.LayoutStyle.ComponentPlacement.UNRELATED)
                        .addGroup(jPanel3Layout.createParallelGroup(javax.swing.GroupLayout.Alignment.LEADING)
                            .addComponent(LabelAjusteInflow, javax.swing.GroupLayout.PREFERRED_SIZE, 69, javax.swing.GroupLayout.PREFERRED_SIZE)
                            .addComponent(LabelFlujoInflow, javax.swing.GroupLayout.PREFERRED_SIZE, 69, javax.swing.GroupLayout.PREFERRED_SIZE)))
                    .addGroup(jPanel3Layout.createSequentialGroup()
                        .addGroup(jPanel3Layout.createParallelGroup(javax.swing.GroupLayout.Alignment.LEADING)
                            .addComponent(jLabel2)
                            .addComponent(jLabel3))
                        .addGap(28, 28, 28)
                        .addGroup(jPanel3Layout.createParallelGroup(javax.swing.GroupLayout.Alignment.LEADING)
                            .addComponent(LabelADCInflow, javax.swing.GroupLayout.PREFERRED_SIZE, 69, javax.swing.GroupLayout.PREFERRED_SIZE)
                            .addComponent(LabelCeroInflow, javax.swing.GroupLayout.PREFERRED_SIZE, 55, javax.swing.GroupLayout.PREFERRED_SIZE))))
                .addContainerGap(javax.swing.GroupLayout.DEFAULT_SIZE, Short.MAX_VALUE))
        );
        jPanel3Layout.setVerticalGroup(
            jPanel3Layout.createParallelGroup(javax.swing.GroupLayout.Alignment.LEADING)
            .addGroup(jPanel3Layout.createSequentialGroup()
                .addContainerGap()
                .addGroup(jPanel3Layout.createParallelGroup(javax.swing.GroupLayout.Alignment.BASELINE)
                    .addComponent(jLabel2)
                    .addComponent(LabelCeroInflow))
                .addPreferredGap(javax.swing.LayoutStyle.ComponentPlacement.UNRELATED)
                .addGroup(jPanel3Layout.createParallelGroup(javax.swing.GroupLayout.Alignment.BASELINE)
                    .addComponent(jLabel3)
                    .addComponent(LabelADCInflow))
                .addPreferredGap(javax.swing.LayoutStyle.ComponentPlacement.UNRELATED)
                .addGroup(jPanel3Layout.createParallelGroup(javax.swing.GroupLayout.Alignment.BASELINE)
                    .addComponent(jLabel4)
                    .addComponent(LabelAjusteInflow))
                .addPreferredGap(javax.swing.LayoutStyle.ComponentPlacement.UNRELATED)
                .addGroup(jPanel3Layout.createParallelGroup(javax.swing.GroupLayout.Alignment.BASELINE)
                    .addComponent(jLabel5)
                    .addComponent(LabelFlujoInflow))
                .addContainerGap())
        );

        jPanel4.setBorder(javax.swing.BorderFactory.createTitledBorder("DownFlow"));

        jLabel6.setFont(new java.awt.Font("Tahoma", 0, 24)); // NOI18N
        jLabel6.setText("ADC:");

        jLabel7.setFont(new java.awt.Font("Tahoma", 0, 24)); // NOI18N
        jLabel7.setText("Cero:");

        LabelCeroDownflow.setFont(new java.awt.Font("Tahoma", 0, 24)); // NOI18N
        LabelCeroDownflow.setText("203");

        jLabel8.setFont(new java.awt.Font("Tahoma", 0, 24)); // NOI18N
        jLabel8.setText("Ajuste *:");

        jLabel9.setFont(new java.awt.Font("Tahoma", 0, 24)); // NOI18N
        jLabel9.setText("Flujo:");

        LabelADCDownflow.setFont(new java.awt.Font("Tahoma", 0, 24)); // NOI18N
        LabelADCDownflow.setText("203");

        LabelFlujoDownflow.setFont(new java.awt.Font("Tahoma", 0, 24)); // NOI18N
        LabelFlujoDownflow.setText("0.53");

        LabelAjusteDownflow.setFont(new java.awt.Font("Tahoma", 0, 24)); // NOI18N
        LabelAjusteDownflow.setText("1.0");

        javax.swing.GroupLayout jPanel4Layout = new javax.swing.GroupLayout(jPanel4);
        jPanel4.setLayout(jPanel4Layout);
        jPanel4Layout.setHorizontalGroup(
            jPanel4Layout.createParallelGroup(javax.swing.GroupLayout.Alignment.LEADING)
            .addGroup(jPanel4Layout.createSequentialGroup()
                .addContainerGap()
                .addGroup(jPanel4Layout.createParallelGroup(javax.swing.GroupLayout.Alignment.LEADING)
                    .addGroup(jPanel4Layout.createSequentialGroup()
                        .addGroup(jPanel4Layout.createParallelGroup(javax.swing.GroupLayout.Alignment.LEADING)
                            .addComponent(jLabel8)
                            .addComponent(jLabel9))
                        .addPreferredGap(javax.swing.LayoutStyle.ComponentPlacement.UNRELATED)
                        .addGroup(jPanel4Layout.createParallelGroup(javax.swing.GroupLayout.Alignment.LEADING)
                            .addComponent(LabelAjusteDownflow, javax.swing.GroupLayout.PREFERRED_SIZE, 69, javax.swing.GroupLayout.PREFERRED_SIZE)
                            .addComponent(LabelFlujoDownflow, javax.swing.GroupLayout.PREFERRED_SIZE, 69, javax.swing.GroupLayout.PREFERRED_SIZE)))
                    .addGroup(jPanel4Layout.createSequentialGroup()
                        .addGroup(jPanel4Layout.createParallelGroup(javax.swing.GroupLayout.Alignment.LEADING)
                            .addComponent(jLabel7)
                            .addComponent(jLabel6))
                        .addGap(28, 28, 28)
                        .addGroup(jPanel4Layout.createParallelGroup(javax.swing.GroupLayout.Alignment.LEADING)
                            .addComponent(LabelADCDownflow, javax.swing.GroupLayout.PREFERRED_SIZE, 69, javax.swing.GroupLayout.PREFERRED_SIZE)
                            .addComponent(LabelCeroDownflow, javax.swing.GroupLayout.PREFERRED_SIZE, 55, javax.swing.GroupLayout.PREFERRED_SIZE))))
                .addContainerGap(javax.swing.GroupLayout.DEFAULT_SIZE, Short.MAX_VALUE))
        );
        jPanel4Layout.setVerticalGroup(
            jPanel4Layout.createParallelGroup(javax.swing.GroupLayout.Alignment.LEADING)
            .addGroup(jPanel4Layout.createSequentialGroup()
                .addContainerGap()
                .addGroup(jPanel4Layout.createParallelGroup(javax.swing.GroupLayout.Alignment.BASELINE)
                    .addComponent(jLabel7)
                    .addComponent(LabelCeroDownflow))
                .addPreferredGap(javax.swing.LayoutStyle.ComponentPlacement.UNRELATED)
                .addGroup(jPanel4Layout.createParallelGroup(javax.swing.GroupLayout.Alignment.BASELINE)
                    .addComponent(jLabel6)
                    .addComponent(LabelADCDownflow))
                .addPreferredGap(javax.swing.LayoutStyle.ComponentPlacement.UNRELATED)
                .addGroup(jPanel4Layout.createParallelGroup(javax.swing.GroupLayout.Alignment.BASELINE)
                    .addComponent(jLabel8)
                    .addComponent(LabelAjusteDownflow))
                .addPreferredGap(javax.swing.LayoutStyle.ComponentPlacement.UNRELATED)
                .addGroup(jPanel4Layout.createParallelGroup(javax.swing.GroupLayout.Alignment.BASELINE)
                    .addComponent(jLabel9)
                    .addComponent(LabelFlujoDownflow))
                .addContainerGap())
        );

        jPanel5.setBorder(javax.swing.BorderFactory.createTitledBorder("Filtro Exhaust"));

        jLabel10.setFont(new java.awt.Font("Tahoma", 0, 24)); // NOI18N
        jLabel10.setText("ADC:");

        jLabel11.setFont(new java.awt.Font("Tahoma", 0, 24)); // NOI18N
        jLabel11.setText("Cero:");

        LabelZeroFInflow.setFont(new java.awt.Font("Tahoma", 0, 24)); // NOI18N
        LabelZeroFInflow.setText("203");

        jLabel12.setFont(new java.awt.Font("Tahoma", 0, 24)); // NOI18N
        jLabel12.setText("Ajuste *:");

        jLabel13.setFont(new java.awt.Font("Tahoma", 0, 24)); // NOI18N
        jLabel13.setText("Presión:");

        LabelADCFInflow.setFont(new java.awt.Font("Tahoma", 0, 24)); // NOI18N
        LabelADCFInflow.setText("203");

        LabelPresionInflow.setFont(new java.awt.Font("Tahoma", 0, 24)); // NOI18N
        LabelPresionInflow.setText("0.53");

        LabelAjusteFInflow.setFont(new java.awt.Font("Tahoma", 0, 24)); // NOI18N
        LabelAjusteFInflow.setText("1.0");

        javax.swing.GroupLayout jPanel5Layout = new javax.swing.GroupLayout(jPanel5);
        jPanel5.setLayout(jPanel5Layout);
        jPanel5Layout.setHorizontalGroup(
            jPanel5Layout.createParallelGroup(javax.swing.GroupLayout.Alignment.LEADING)
            .addGroup(jPanel5Layout.createSequentialGroup()
                .addContainerGap()
                .addGroup(jPanel5Layout.createParallelGroup(javax.swing.GroupLayout.Alignment.LEADING)
                    .addGroup(jPanel5Layout.createSequentialGroup()
                        .addGroup(jPanel5Layout.createParallelGroup(javax.swing.GroupLayout.Alignment.LEADING)
                            .addComponent(jLabel12)
                            .addComponent(jLabel13))
                        .addPreferredGap(javax.swing.LayoutStyle.ComponentPlacement.UNRELATED)
                        .addGroup(jPanel5Layout.createParallelGroup(javax.swing.GroupLayout.Alignment.LEADING)
                            .addComponent(LabelAjusteFInflow, javax.swing.GroupLayout.PREFERRED_SIZE, 69, javax.swing.GroupLayout.PREFERRED_SIZE)
                            .addComponent(LabelPresionInflow, javax.swing.GroupLayout.PREFERRED_SIZE, 69, javax.swing.GroupLayout.PREFERRED_SIZE)))
                    .addGroup(jPanel5Layout.createSequentialGroup()
                        .addGroup(jPanel5Layout.createParallelGroup(javax.swing.GroupLayout.Alignment.LEADING)
                            .addComponent(jLabel11)
                            .addComponent(jLabel10))
                        .addGap(28, 28, 28)
                        .addGroup(jPanel5Layout.createParallelGroup(javax.swing.GroupLayout.Alignment.LEADING)
                            .addComponent(LabelADCFInflow, javax.swing.GroupLayout.PREFERRED_SIZE, 69, javax.swing.GroupLayout.PREFERRED_SIZE)
                            .addComponent(LabelZeroFInflow, javax.swing.GroupLayout.PREFERRED_SIZE, 55, javax.swing.GroupLayout.PREFERRED_SIZE))))
                .addContainerGap(javax.swing.GroupLayout.DEFAULT_SIZE, Short.MAX_VALUE))
        );
        jPanel5Layout.setVerticalGroup(
            jPanel5Layout.createParallelGroup(javax.swing.GroupLayout.Alignment.LEADING)
            .addGroup(jPanel5Layout.createSequentialGroup()
                .addContainerGap()
                .addGroup(jPanel5Layout.createParallelGroup(javax.swing.GroupLayout.Alignment.BASELINE)
                    .addComponent(jLabel11)
                    .addComponent(LabelZeroFInflow))
                .addPreferredGap(javax.swing.LayoutStyle.ComponentPlacement.UNRELATED)
                .addGroup(jPanel5Layout.createParallelGroup(javax.swing.GroupLayout.Alignment.BASELINE)
                    .addComponent(jLabel10)
                    .addComponent(LabelADCFInflow))
                .addPreferredGap(javax.swing.LayoutStyle.ComponentPlacement.UNRELATED)
                .addGroup(jPanel5Layout.createParallelGroup(javax.swing.GroupLayout.Alignment.BASELINE)
                    .addComponent(jLabel12)
                    .addComponent(LabelAjusteFInflow))
                .addPreferredGap(javax.swing.LayoutStyle.ComponentPlacement.UNRELATED)
                .addGroup(jPanel5Layout.createParallelGroup(javax.swing.GroupLayout.Alignment.BASELINE)
                    .addComponent(jLabel13)
                    .addComponent(LabelPresionInflow))
                .addContainerGap())
        );

        jPanel6.setBorder(javax.swing.BorderFactory.createTitledBorder("Filtro DownFlow"));

        jLabel14.setFont(new java.awt.Font("Tahoma", 0, 24)); // NOI18N
        jLabel14.setText("ADC:");

        jLabel15.setFont(new java.awt.Font("Tahoma", 0, 24)); // NOI18N
        jLabel15.setText("Cero:");

        LabelZeroFDownflow.setFont(new java.awt.Font("Tahoma", 0, 24)); // NOI18N
        LabelZeroFDownflow.setText("203");

        jLabel16.setFont(new java.awt.Font("Tahoma", 0, 24)); // NOI18N
        jLabel16.setText("Ajuste *:");

        jLabel17.setFont(new java.awt.Font("Tahoma", 0, 24)); // NOI18N
        jLabel17.setText("Presión:");

        LabelADCFDownflow.setFont(new java.awt.Font("Tahoma", 0, 24)); // NOI18N
        LabelADCFDownflow.setText("203");

        LabelPresionDownflow.setFont(new java.awt.Font("Tahoma", 0, 24)); // NOI18N
        LabelPresionDownflow.setText("0.53");

        LabelAjusteFDownflow.setFont(new java.awt.Font("Tahoma", 0, 24)); // NOI18N
        LabelAjusteFDownflow.setText("1.0");

        javax.swing.GroupLayout jPanel6Layout = new javax.swing.GroupLayout(jPanel6);
        jPanel6.setLayout(jPanel6Layout);
        jPanel6Layout.setHorizontalGroup(
            jPanel6Layout.createParallelGroup(javax.swing.GroupLayout.Alignment.LEADING)
            .addGroup(jPanel6Layout.createSequentialGroup()
                .addContainerGap()
                .addGroup(jPanel6Layout.createParallelGroup(javax.swing.GroupLayout.Alignment.LEADING)
                    .addGroup(jPanel6Layout.createSequentialGroup()
                        .addGroup(jPanel6Layout.createParallelGroup(javax.swing.GroupLayout.Alignment.LEADING)
                            .addComponent(jLabel16)
                            .addComponent(jLabel17))
                        .addPreferredGap(javax.swing.LayoutStyle.ComponentPlacement.UNRELATED)
                        .addGroup(jPanel6Layout.createParallelGroup(javax.swing.GroupLayout.Alignment.LEADING)
                            .addComponent(LabelAjusteFDownflow, javax.swing.GroupLayout.PREFERRED_SIZE, 69, javax.swing.GroupLayout.PREFERRED_SIZE)
                            .addComponent(LabelPresionDownflow, javax.swing.GroupLayout.PREFERRED_SIZE, 69, javax.swing.GroupLayout.PREFERRED_SIZE)))
                    .addGroup(jPanel6Layout.createSequentialGroup()
                        .addGroup(jPanel6Layout.createParallelGroup(javax.swing.GroupLayout.Alignment.LEADING)
                            .addComponent(jLabel15)
                            .addComponent(jLabel14))
                        .addGap(28, 28, 28)
                        .addGroup(jPanel6Layout.createParallelGroup(javax.swing.GroupLayout.Alignment.LEADING)
                            .addComponent(LabelADCFDownflow, javax.swing.GroupLayout.PREFERRED_SIZE, 69, javax.swing.GroupLayout.PREFERRED_SIZE)
                            .addComponent(LabelZeroFDownflow, javax.swing.GroupLayout.PREFERRED_SIZE, 55, javax.swing.GroupLayout.PREFERRED_SIZE))))
                .addContainerGap(javax.swing.GroupLayout.DEFAULT_SIZE, Short.MAX_VALUE))
        );
        jPanel6Layout.setVerticalGroup(
            jPanel6Layout.createParallelGroup(javax.swing.GroupLayout.Alignment.LEADING)
            .addGroup(jPanel6Layout.createSequentialGroup()
                .addContainerGap()
                .addGroup(jPanel6Layout.createParallelGroup(javax.swing.GroupLayout.Alignment.BASELINE)
                    .addComponent(jLabel15)
                    .addComponent(LabelZeroFDownflow))
                .addPreferredGap(javax.swing.LayoutStyle.ComponentPlacement.UNRELATED)
                .addGroup(jPanel6Layout.createParallelGroup(javax.swing.GroupLayout.Alignment.BASELINE)
                    .addComponent(jLabel14)
                    .addComponent(LabelADCFDownflow))
                .addPreferredGap(javax.swing.LayoutStyle.ComponentPlacement.UNRELATED)
                .addGroup(jPanel6Layout.createParallelGroup(javax.swing.GroupLayout.Alignment.BASELINE)
                    .addComponent(jLabel16)
                    .addComponent(LabelAjusteFDownflow))
                .addPreferredGap(javax.swing.LayoutStyle.ComponentPlacement.UNRELATED)
                .addGroup(jPanel6Layout.createParallelGroup(javax.swing.GroupLayout.Alignment.BASELINE)
                    .addComponent(jLabel17)
                    .addComponent(LabelPresionDownflow))
                .addContainerGap())
        );

        jPanel2.setBorder(javax.swing.BorderFactory.createTitledBorder("Otros"));

        jLabel18.setFont(new java.awt.Font("Tahoma", 0, 24)); // NOI18N
        jLabel18.setText("Vidrio UP:");

        LabelVidrioUP.setFont(new java.awt.Font("Tahoma", 0, 24)); // NOI18N
        LabelVidrioUP.setText("203");

        LabelVidrioDN.setFont(new java.awt.Font("Tahoma", 0, 24)); // NOI18N
        LabelVidrioDN.setText("203");

        jLabel19.setFont(new java.awt.Font("Tahoma", 0, 24)); // NOI18N
        jLabel19.setText("Vidrio DN:");

        LabelDamper.setFont(new java.awt.Font("Tahoma", 0, 24)); // NOI18N
        LabelDamper.setText("203");

        jLabel20.setFont(new java.awt.Font("Tahoma", 0, 24)); // NOI18N
        jLabel20.setText("Damper:");

        LabelTecla.setFont(new java.awt.Font("Tahoma", 0, 24)); // NOI18N
        LabelTecla.setText("---");

        jLabel21.setFont(new java.awt.Font("Tahoma", 0, 24)); // NOI18N
        jLabel21.setText("Tecla:");

        jLabel22.setFont(new java.awt.Font("Tahoma", 0, 24)); // NOI18N
        jLabel22.setText("Vidrio UUP:");

        LabelVidrioUUP.setFont(new java.awt.Font("Tahoma", 0, 24)); // NOI18N
        LabelVidrioUUP.setText("203");

        javax.swing.GroupLayout jPanel2Layout = new javax.swing.GroupLayout(jPanel2);
        jPanel2.setLayout(jPanel2Layout);
        jPanel2Layout.setHorizontalGroup(
            jPanel2Layout.createParallelGroup(javax.swing.GroupLayout.Alignment.LEADING)
            .addGroup(jPanel2Layout.createSequentialGroup()
                .addContainerGap()
                .addGroup(jPanel2Layout.createParallelGroup(javax.swing.GroupLayout.Alignment.LEADING)
                    .addComponent(jLabel18)
                    .addComponent(jLabel19)
                    .addGroup(jPanel2Layout.createParallelGroup(javax.swing.GroupLayout.Alignment.LEADING)
                        .addGroup(javax.swing.GroupLayout.Alignment.TRAILING, jPanel2Layout.createSequentialGroup()
                            .addPreferredGap(javax.swing.LayoutStyle.ComponentPlacement.RELATED, 30, javax.swing.GroupLayout.PREFERRED_SIZE)
                            .addComponent(LabelDamper, javax.swing.GroupLayout.PREFERRED_SIZE, 85, javax.swing.GroupLayout.PREFERRED_SIZE))
                        .addComponent(jLabel20)
                        .addGroup(jPanel2Layout.createParallelGroup(javax.swing.GroupLayout.Alignment.LEADING)
                            .addGroup(javax.swing.GroupLayout.Alignment.TRAILING, jPanel2Layout.createSequentialGroup()
                                .addPreferredGap(javax.swing.LayoutStyle.ComponentPlacement.RELATED, 30, javax.swing.GroupLayout.PREFERRED_SIZE)
                                .addComponent(LabelTecla, javax.swing.GroupLayout.PREFERRED_SIZE, 85, javax.swing.GroupLayout.PREFERRED_SIZE))
                            .addComponent(jLabel21)))
                    .addComponent(jLabel22)
                    .addGroup(jPanel2Layout.createSequentialGroup()
                        .addGap(12, 12, 12)
                        .addGroup(jPanel2Layout.createParallelGroup(javax.swing.GroupLayout.Alignment.LEADING)
                            .addComponent(LabelVidrioUP, javax.swing.GroupLayout.PREFERRED_SIZE, 85, javax.swing.GroupLayout.PREFERRED_SIZE)
                            .addComponent(LabelVidrioDN, javax.swing.GroupLayout.PREFERRED_SIZE, 85, javax.swing.GroupLayout.PREFERRED_SIZE)
                            .addComponent(LabelVidrioUUP, javax.swing.GroupLayout.PREFERRED_SIZE, 85, javax.swing.GroupLayout.PREFERRED_SIZE))))
                .addContainerGap(javax.swing.GroupLayout.DEFAULT_SIZE, Short.MAX_VALUE))
        );
        jPanel2Layout.setVerticalGroup(
            jPanel2Layout.createParallelGroup(javax.swing.GroupLayout.Alignment.LEADING)
            .addGroup(jPanel2Layout.createSequentialGroup()
                .addComponent(jLabel18)
                .addPreferredGap(javax.swing.LayoutStyle.ComponentPlacement.RELATED)
                .addComponent(LabelVidrioUP)
                .addPreferredGap(javax.swing.LayoutStyle.ComponentPlacement.RELATED)
                .addComponent(jLabel19)
                .addPreferredGap(javax.swing.LayoutStyle.ComponentPlacement.RELATED)
                .addComponent(LabelVidrioDN)
                .addPreferredGap(javax.swing.LayoutStyle.ComponentPlacement.RELATED, javax.swing.GroupLayout.DEFAULT_SIZE, Short.MAX_VALUE)
                .addComponent(jLabel22)
                .addPreferredGap(javax.swing.LayoutStyle.ComponentPlacement.RELATED)
                .addComponent(LabelVidrioUUP)
                .addPreferredGap(javax.swing.LayoutStyle.ComponentPlacement.UNRELATED)
                .addComponent(jLabel20)
                .addPreferredGap(javax.swing.LayoutStyle.ComponentPlacement.RELATED)
                .addComponent(LabelDamper)
                .addPreferredGap(javax.swing.LayoutStyle.ComponentPlacement.RELATED)
                .addComponent(jLabel21)
                .addPreferredGap(javax.swing.LayoutStyle.ComponentPlacement.RELATED)
                .addComponent(LabelTecla)
                .addContainerGap())
        );

        javax.swing.GroupLayout jPanel1Layout = new javax.swing.GroupLayout(jPanel1);
        jPanel1.setLayout(jPanel1Layout);
        jPanel1Layout.setHorizontalGroup(
            jPanel1Layout.createParallelGroup(javax.swing.GroupLayout.Alignment.LEADING)
            .addComponent(jLabel1, javax.swing.GroupLayout.Alignment.TRAILING, javax.swing.GroupLayout.DEFAULT_SIZE, javax.swing.GroupLayout.DEFAULT_SIZE, Short.MAX_VALUE)
            .addGroup(jPanel1Layout.createSequentialGroup()
                .addContainerGap()
                .addGroup(jPanel1Layout.createParallelGroup(javax.swing.GroupLayout.Alignment.LEADING)
                    .addGroup(jPanel1Layout.createSequentialGroup()
                        .addComponent(jPanel3, javax.swing.GroupLayout.PREFERRED_SIZE, 205, javax.swing.GroupLayout.PREFERRED_SIZE)
                        .addPreferredGap(javax.swing.LayoutStyle.ComponentPlacement.UNRELATED)
                        .addComponent(jPanel4, javax.swing.GroupLayout.PREFERRED_SIZE, 205, javax.swing.GroupLayout.PREFERRED_SIZE))
                    .addGroup(jPanel1Layout.createSequentialGroup()
                        .addComponent(jPanel5, javax.swing.GroupLayout.PREFERRED_SIZE, 205, javax.swing.GroupLayout.PREFERRED_SIZE)
                        .addPreferredGap(javax.swing.LayoutStyle.ComponentPlacement.UNRELATED)
                        .addComponent(jPanel6, javax.swing.GroupLayout.PREFERRED_SIZE, 205, javax.swing.GroupLayout.PREFERRED_SIZE)))
                .addPreferredGap(javax.swing.LayoutStyle.ComponentPlacement.RELATED)
                .addComponent(jPanel2, javax.swing.GroupLayout.DEFAULT_SIZE, javax.swing.GroupLayout.DEFAULT_SIZE, Short.MAX_VALUE)
                .addContainerGap())
        );
        jPanel1Layout.setVerticalGroup(
            jPanel1Layout.createParallelGroup(javax.swing.GroupLayout.Alignment.LEADING)
            .addGroup(jPanel1Layout.createSequentialGroup()
                .addComponent(jLabel1)
                .addGroup(jPanel1Layout.createParallelGroup(javax.swing.GroupLayout.Alignment.LEADING)
                    .addGroup(jPanel1Layout.createSequentialGroup()
                        .addPreferredGap(javax.swing.LayoutStyle.ComponentPlacement.RELATED)
                        .addGroup(jPanel1Layout.createParallelGroup(javax.swing.GroupLayout.Alignment.TRAILING)
                            .addComponent(jPanel3, javax.swing.GroupLayout.PREFERRED_SIZE, javax.swing.GroupLayout.DEFAULT_SIZE, javax.swing.GroupLayout.PREFERRED_SIZE)
                            .addComponent(jPanel4, javax.swing.GroupLayout.PREFERRED_SIZE, javax.swing.GroupLayout.DEFAULT_SIZE, javax.swing.GroupLayout.PREFERRED_SIZE))
                        .addPreferredGap(javax.swing.LayoutStyle.ComponentPlacement.RELATED, javax.swing.GroupLayout.DEFAULT_SIZE, Short.MAX_VALUE)
                        .addGroup(jPanel1Layout.createParallelGroup(javax.swing.GroupLayout.Alignment.LEADING)
                            .addComponent(jPanel5, javax.swing.GroupLayout.PREFERRED_SIZE, javax.swing.GroupLayout.DEFAULT_SIZE, javax.swing.GroupLayout.PREFERRED_SIZE)
                            .addComponent(jPanel6, javax.swing.GroupLayout.PREFERRED_SIZE, javax.swing.GroupLayout.DEFAULT_SIZE, javax.swing.GroupLayout.PREFERRED_SIZE)))
                    .addGroup(jPanel1Layout.createSequentialGroup()
                        .addGap(14, 14, 14)
                        .addComponent(jPanel2, javax.swing.GroupLayout.DEFAULT_SIZE, javax.swing.GroupLayout.DEFAULT_SIZE, Short.MAX_VALUE)))
                .addContainerGap())
        );

        javax.swing.GroupLayout layout = new javax.swing.GroupLayout(getContentPane());
        getContentPane().setLayout(layout);
        layout.setHorizontalGroup(
            layout.createParallelGroup(javax.swing.GroupLayout.Alignment.LEADING)
            .addGroup(layout.createSequentialGroup()
                .addComponent(jPanel1, javax.swing.GroupLayout.PREFERRED_SIZE, javax.swing.GroupLayout.DEFAULT_SIZE, javax.swing.GroupLayout.PREFERRED_SIZE)
                .addGap(0, 0, Short.MAX_VALUE))
        );
        layout.setVerticalGroup(
            layout.createParallelGroup(javax.swing.GroupLayout.Alignment.LEADING)
            .addGroup(layout.createSequentialGroup()
                .addComponent(jPanel1, javax.swing.GroupLayout.PREFERRED_SIZE, javax.swing.GroupLayout.DEFAULT_SIZE, javax.swing.GroupLayout.PREFERRED_SIZE)
                .addGap(0, 0, Short.MAX_VALUE))
        );

        pack();
    }// </editor-fold>//GEN-END:initComponents

    /**
     * @param args the command line arguments
     */
    public static void main(String args[]) {
        /* Set the Nimbus look and feel */
        //<editor-fold defaultstate="collapsed" desc=" Look and feel setting code (optional) ">
        /* If Nimbus (introduced in Java SE 6) is not available, stay with the default look and feel.
         * For details see http://download.oracle.com/javase/tutorial/uiswing/lookandfeel/plaf.html 
         */
        try {
            for (javax.swing.UIManager.LookAndFeelInfo info : javax.swing.UIManager.getInstalledLookAndFeels()) {
                if ("Nimbus".equals(info.getName())) {
                    javax.swing.UIManager.setLookAndFeel(info.getClassName());
                    break;
                }
            }
        } catch (ClassNotFoundException ex) {
            java.util.logging.Logger.getLogger(Menu_Mantenimiento.class.getName()).log(java.util.logging.Level.SEVERE, null, ex);
        } catch (InstantiationException ex) {
            java.util.logging.Logger.getLogger(Menu_Mantenimiento.class.getName()).log(java.util.logging.Level.SEVERE, null, ex);
        } catch (IllegalAccessException ex) {
            java.util.logging.Logger.getLogger(Menu_Mantenimiento.class.getName()).log(java.util.logging.Level.SEVERE, null, ex);
        } catch (javax.swing.UnsupportedLookAndFeelException ex) {
            java.util.logging.Logger.getLogger(Menu_Mantenimiento.class.getName()).log(java.util.logging.Level.SEVERE, null, ex);
        }
        //</editor-fold>
        //</editor-fold>
        //</editor-fold>
        //</editor-fold>
        //</editor-fold>
        //</editor-fold>
        //</editor-fold>
        //</editor-fold>
        //</editor-fold>
        //</editor-fold>
        //</editor-fold>
        //</editor-fold>
        //</editor-fold>
        //</editor-fold>
        //</editor-fold>
        //</editor-fold>
        //</editor-fold>
        //</editor-fold>
        //</editor-fold>
        //</editor-fold>
        //</editor-fold>
        //</editor-fold>
        //</editor-fold>
        //</editor-fold>
        //</editor-fold>
        //</editor-fold>
        //</editor-fold>
        //</editor-fold>
        //</editor-fold>
        //</editor-fold>
        //</editor-fold>
        //</editor-fold>

        /* Create and display the form */
        java.awt.EventQueue.invokeLater(new Runnable() {
            public void run() {
                new Menu_Mantenimiento().setVisible(true);
            }
        });
    }

    // Variables declaration - do not modify//GEN-BEGIN:variables
    public static javax.swing.JLabel LabelADCDownflow;
    public static javax.swing.JLabel LabelADCFDownflow;
    public static javax.swing.JLabel LabelADCFInflow;
    public static javax.swing.JLabel LabelADCInflow;
    public static javax.swing.JLabel LabelAjusteDownflow;
    public static javax.swing.JLabel LabelAjusteFDownflow;
    public static javax.swing.JLabel LabelAjusteFInflow;
    public static javax.swing.JLabel LabelAjusteInflow;
    public static javax.swing.JLabel LabelCeroDownflow;
    public static javax.swing.JLabel LabelCeroInflow;
    public static javax.swing.JLabel LabelDamper;
    public static javax.swing.JLabel LabelFlujoDownflow;
    public static javax.swing.JLabel LabelFlujoInflow;
    public static javax.swing.JLabel LabelPresionDownflow;
    public static javax.swing.JLabel LabelPresionInflow;
    public static javax.swing.JLabel LabelTecla;
    public static javax.swing.JLabel LabelVidrioDN;
    public static javax.swing.JLabel LabelVidrioUP;
    public static javax.swing.JLabel LabelVidrioUUP;
    public static javax.swing.JLabel LabelZeroFDownflow;
    public static javax.swing.JLabel LabelZeroFInflow;
    private javax.swing.JLabel jLabel1;
    private javax.swing.JLabel jLabel10;
    private javax.swing.JLabel jLabel11;
    private javax.swing.JLabel jLabel12;
    private javax.swing.JLabel jLabel13;
    private javax.swing.JLabel jLabel14;
    private javax.swing.JLabel jLabel15;
    private javax.swing.JLabel jLabel16;
    private javax.swing.JLabel jLabel17;
    private javax.swing.JLabel jLabel18;
    private javax.swing.JLabel jLabel19;
    private javax.swing.JLabel jLabel2;
    private javax.swing.JLabel jLabel20;
    private javax.swing.JLabel jLabel21;
    private javax.swing.JLabel jLabel22;
    private javax.swing.JLabel jLabel3;
    private javax.swing.JLabel jLabel4;
    private javax.swing.JLabel jLabel5;
    private javax.swing.JLabel jLabel6;
    private javax.swing.JLabel jLabel7;
    private javax.swing.JLabel jLabel8;
    private javax.swing.JLabel jLabel9;
    private javax.swing.JPanel jPanel1;
    private javax.swing.JPanel jPanel2;
    private javax.swing.JPanel jPanel3;
    private javax.swing.JPanel jPanel4;
    private javax.swing.JPanel jPanel5;
    private javax.swing.JPanel jPanel6;
    // End of variables declaration//GEN-END:variables
}
